sky9464881/tof-lidar-receiver-design/results/bench_final/6.2 final opa695_100  compartor 0 lowpass 5.6pF/opa695 Cin=10pF,Cf=1pF Riso= 0,R695=100 ohm ATT=2 comparator r 0ohm noise.jpg

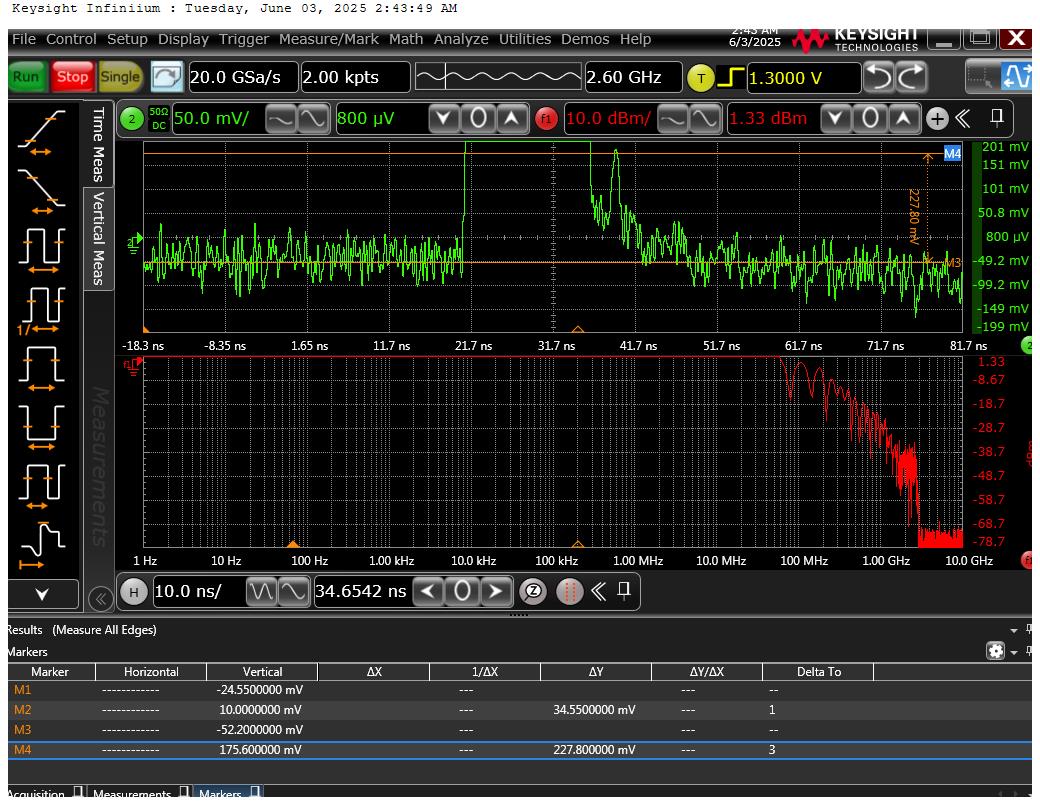
results/bench_final/6.2 final opa695_100 compartor 0 lowpass 5.6pF/opa695 Cin=10pF,Cf=1pF Riso= 0,R695=100 ohm ATT=2 comparator r 0ohm noise.jpg
