sky9464881/tof-lidar-receiver-design/design/footprint_library/footprint/.html

## pad22sq18

date/time: 2023/06/14 16:31:07

type: Through Pin
units: mm
decimal places: 3

Hole data

geometry: Circle
size: 1.800
offset: (0.000, 0.000)
tolerance: positive=0.000 negative=0.000
plating: Plated

Drill symbol data

geometry: Hexagon y
width: 1.270
height: 1.270
characters:

Design layer pads

Layer: TOP

Pad | Geometry | Width | Height | X offset | Y offset
Regular | Square | 2.300 | 2.300 | 0.000 | 0.000
Thermal | None
Anti | None
Keep Out | None

Layer: DEFAULT INTERNAL

Pad | Geometry | Width | Height | X offset | Y offset
Regular | Round | 2.200 | 2.200 | 0.000 | 0.000
Thermal | Round | 1.905 | 1.905 | 0.000 | 0.000
Anti | Round | 1.905 | 1.905 | 0.000 | 0.000
Keep Out | None

Layer: BOTTOM

Pad | Geometry | Width | Height | X offset | Y offset
Regular | Square | 2.300 | 2.300 | 0.000 | 0.000
Thermal | None
Anti | None
Keep Out | None

Layer: ADJACENT LAYER

Pad | Geometry | Width | Height | X offset | Y offset
Regular | None
Thermal | None
Anti | None
Keep Out | None

Mask layer pads

Layer | Geometry | Width | Height | X offset | Y offset
SOLDERMASK_TOP | Square | 1.905 | 1.905 | 0.000 | 0.000
SOLDERMASK_BOTTOM | Square | 1.905 | 1.905 | 0.000 | 0.000
PASTEMASK_TOP | None
PASTEMASK_BOTTOM | None
FILMMASK_TOP | None
FILMMASK_BOTTOM | None
COVERLAY_TOP | None
COVERLAY_BOTTOM | None

Usage options

Suppress unconnected internal pads: No
Allow as template padstack: No
