sky9464881/tof-lidar-receiver-design/docs/drafts/새 Microsoft PowerPoint 프레젠테이션.pptx

## 5/22 미팅용 자료

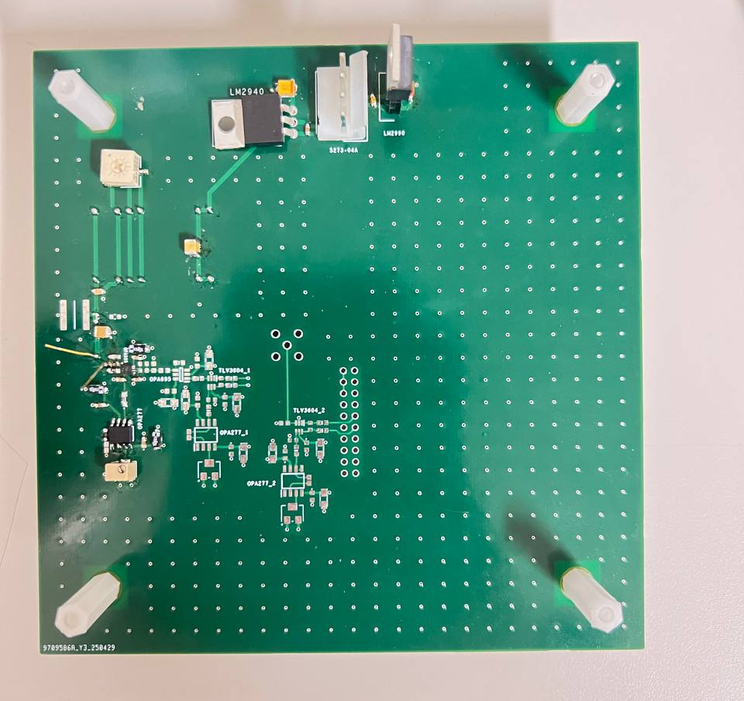
[picture p3: figure]

현재 진행사항

## 5V 전압 인가

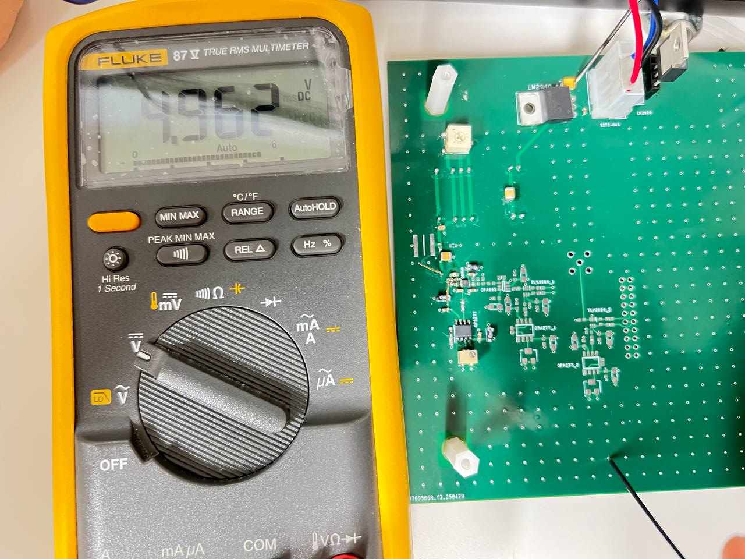
[picture p4: figure]

## -5V 전압 인가

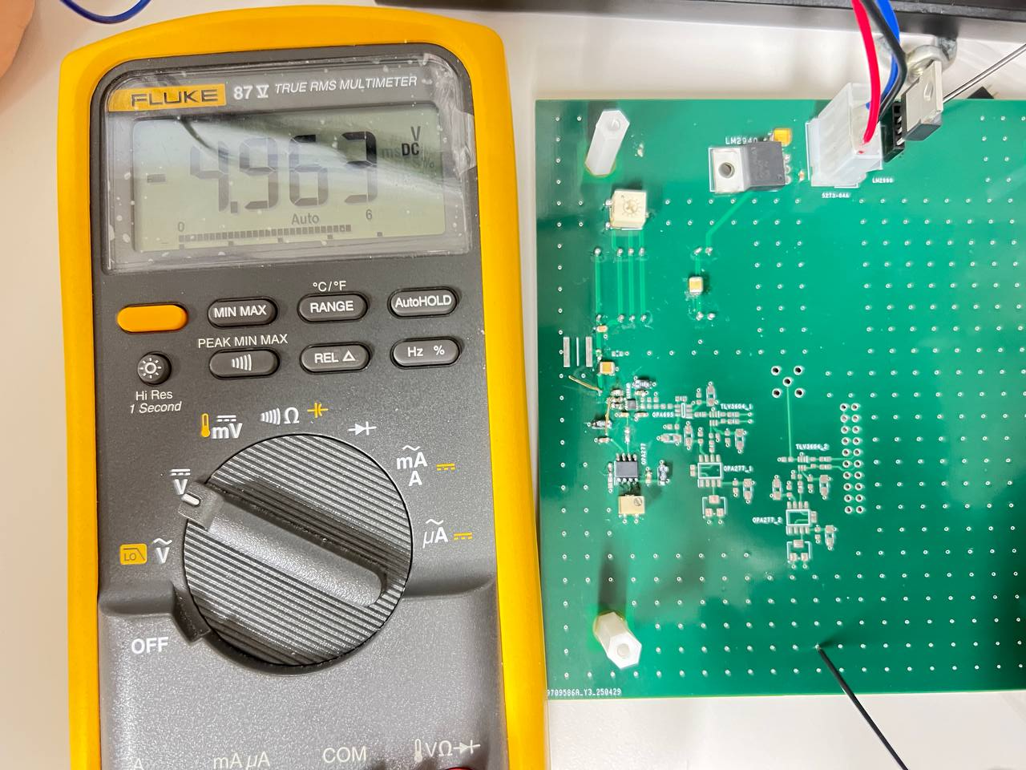
[picture p5: figure]

## apd 바이어스 (120V)

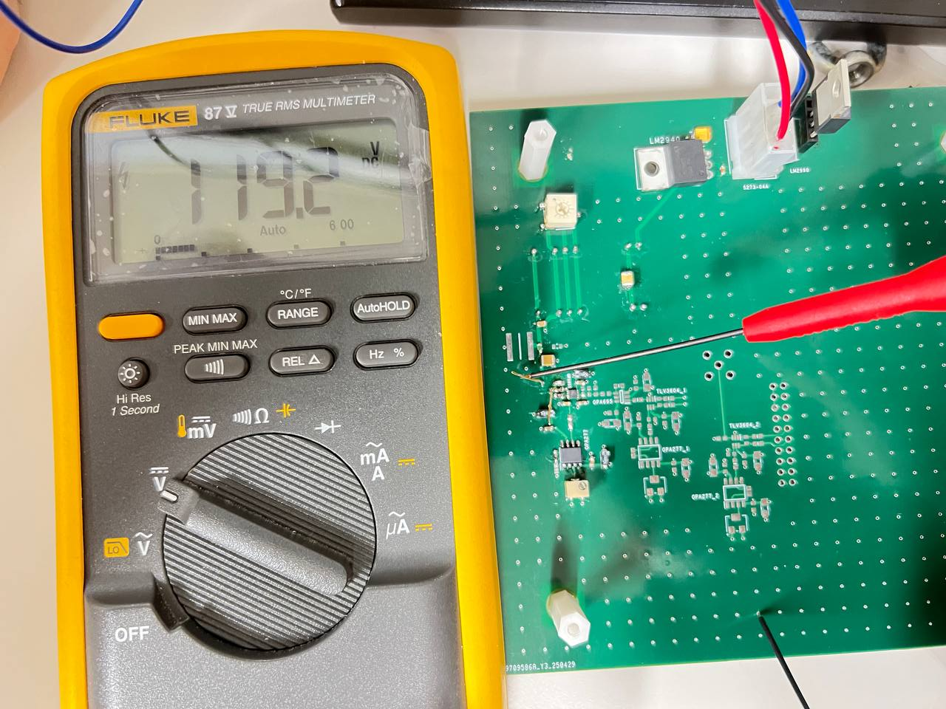
[picture p6: figure]

## OPA855 output offset

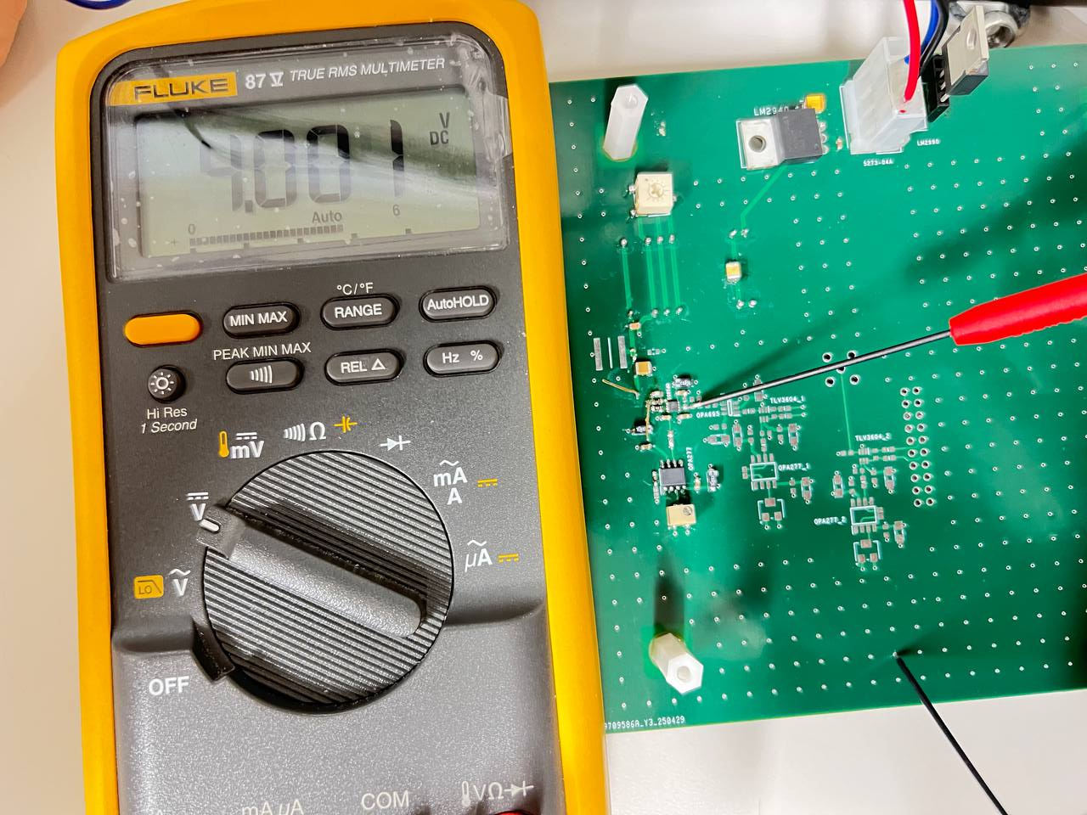
[picture p7: figure]

## OPA 855output 확인용 점프선, RF커넥터

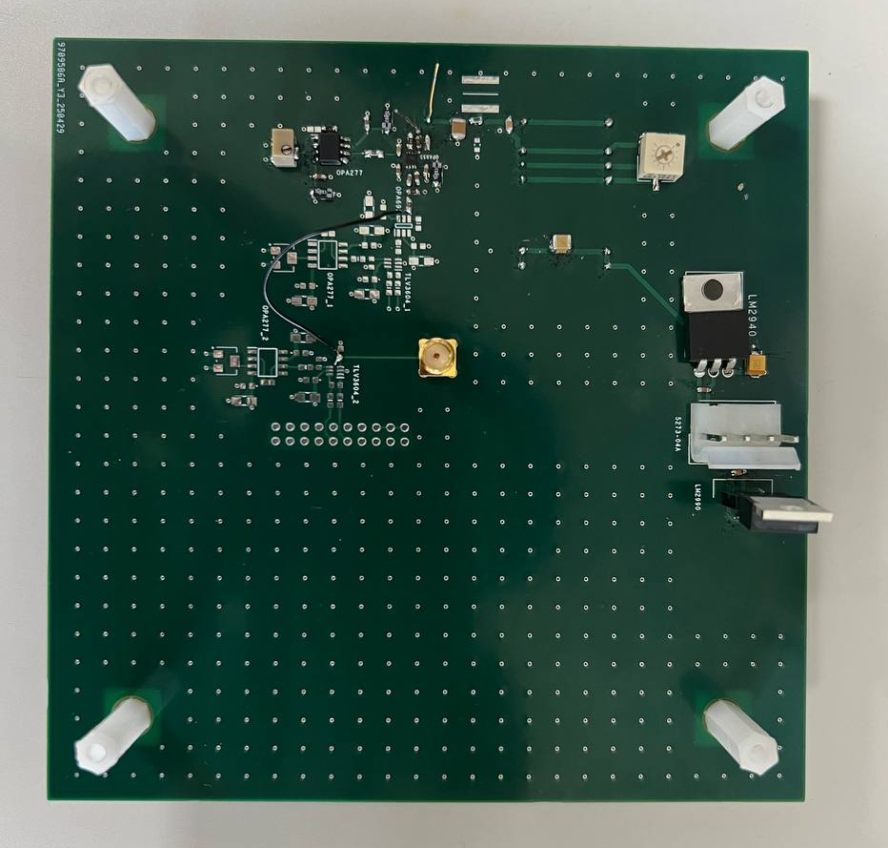
[picture p8: figure]
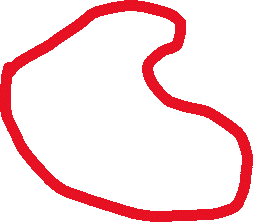
[picture p9: figure]

## Slide 7

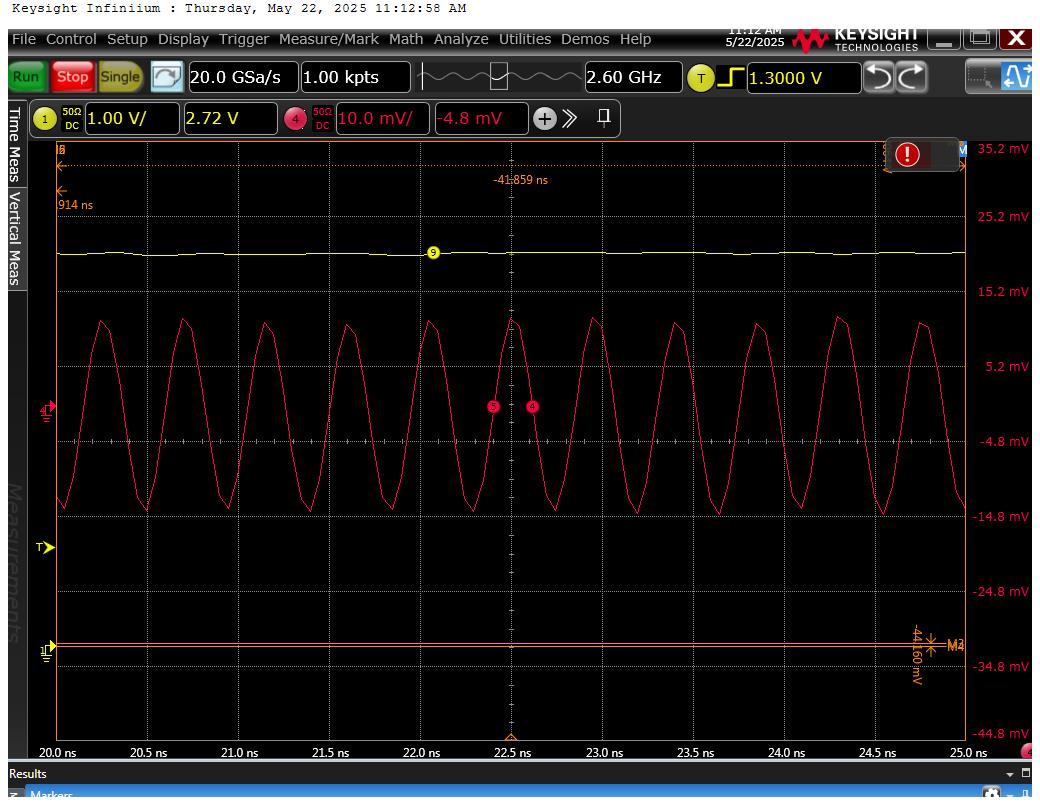
[picture p10: figure]
