sky9464881/tof-lidar-receiver-design/docs/drafts/새 Microsoft Word 문서 (3).docx

1. 시스템 requirement

Dynamic Range | 60dB
거리 범위 | 5.4m~117.9m
해상도(Range resolution) | ≤ 15 [mm] (100 ps walk)

시스템 requirement의 선정 과정를 거치면서 소자 선정과정을 같이 진행해 나갔다. 시스템 requirement를 작성하면서 고려해야할 부분은 Bandwidth, Signal to noise ratio, Dynamic range등 이 있다.

우리는 위에 기준을 먼저 고려하고 그에 맞춰 거리범위까지 선정하였다. 먼저 Bandwidth는 Lidar에 쓰이는 송신부의 rise time과 수신부의 APD의 rise time에 따라 선정된다. 우리가 사용하는 레이저 다이오드는 qs-905-D1S3JT03U로써 그 raise time이 1.4ns이고 APD의 raise time은 0.6ns로 총 rise time은 약 1ns이고 따라서 Bandwidth는 약 350Mhz이다

다음으로는 SNR를 선정하였다. SNR은 전류의 신호의 peak값을 input-referred noise로 나눈 것으로 시스템의 안정성을 위해 8-10 사이의 SNR을 요구하므로 이 캡스톤에서는 10dB의 SNR으로 선정하였다. (참고논문추가) 그리고 TIA출력의 등가 잡음 전압를 계산하고, SNR를 10 dB로 설정하여 APD의 최소 출력 전류 요건을 역 산출하였다. TIA출력의 등가 잡음 전압을 구할 때는 TIA의 피드백 저항과 피드백 캡을 고려해야 한다. 이 부분은 TIA의 saturation 영역을 최대한 포함하지않게 하기 위해 낮은 게인값 즉 저항을 선정하려고 했고 그리고 그 피드백 저항을 고려한 Cap을 선정하려고 했다.

TIA의 등가 잡음 전압은 세가지 noise를 통해 구할 수 있다. Thermal noise, input current noise, voltage noise이다. 이 noise들을 계산해서 총 noise level를 구한다. 이 캡스톤에서는 피드백 소자로 R_f = 500ohm, C_f = 1pF, C_(in) =12pF (기생캐패시턴스를 고려한 캐패시턴스)이다.

f_(3dB) =1/(2πR_f C_f) , ENBW=f_(3dB) ×π/2

TIA의 3dB BW는 위에 식으로 계산하면 318.3MHz이고 ENBW는 500MHz이다

Noise_(Thermal) =√(4kT×ENBW×R_f)

(T:절대 온도 (여기서는 300K로 계산), k: 볼트만상수 1.38× 10^(-28) [J/K])

Noise_(Current) =e_i ×R_f ×√(ENBW)

( e_i : 증폭기의 입력 기준 전류 잡음)

Noise_(Thermal) = e_v ×(C_f +C_(APD) +C_(in))/(C_f)×√(π/2×BW×(C_f)/(C_f +C_(APD) +C_(in)))

( e_v : 증폭기의 입력 기준 전압 잡음)

이러한 최소 광전류는 라이다의 최대 거리 사양과 연결된다.

I_(APD) =P_R ×R_(APD)

( I_(APD) : APD의 전류, P_R : 수신되는 광전력, R_(APD) : APD의 응답도)

P_R =(τ_a ^2 P_T ρ_t A_R)/(πR^2)

( P_T : 레이저 다이오드의 펄스 피크 출력 전력, τ_a : 대기 중 레이저 투과율, ρ_t : 대상 물체의 반사율, A_R : 수신 렌즈의 면적, R : 수신기와 대상 간의 거리)

APD의 응답도인 55A/W와 APD의 전류인 I_(APD) 의 범위를 통해 수신되는 광전력인 P_R 의 범위를 구하고 그에 따라 거리탐지 범위를 산출하였다. 그에 따라 거리인 R 의 범위가 5.4m~117.9m로 정해졌다. 해상도와 관련해서는, 목표 해상도를 시간으로 환산하여 수신부 전자회로의 대역폭인을 고려하여 설정하였다. 이러한 체계적인 접근을 통해 시스템 사양을 현실적으로 달성하기 위한 설계 기준을 확립하였다.

다음으로는 TIA출력의 등가 잡음 전압을 계산한다. TIA의 noise는 크게 세가지로 나눌 수 있다. Thermal noise, input current noise, voltage noise이다. 이 noise를 계산해서 총 noise level를 구한다.

Noise_(Thermal) =√(4kT×ENBW×R_f)
