sky9464881/tof-lidar-receiver-design/docs/drafts/질문.pdf

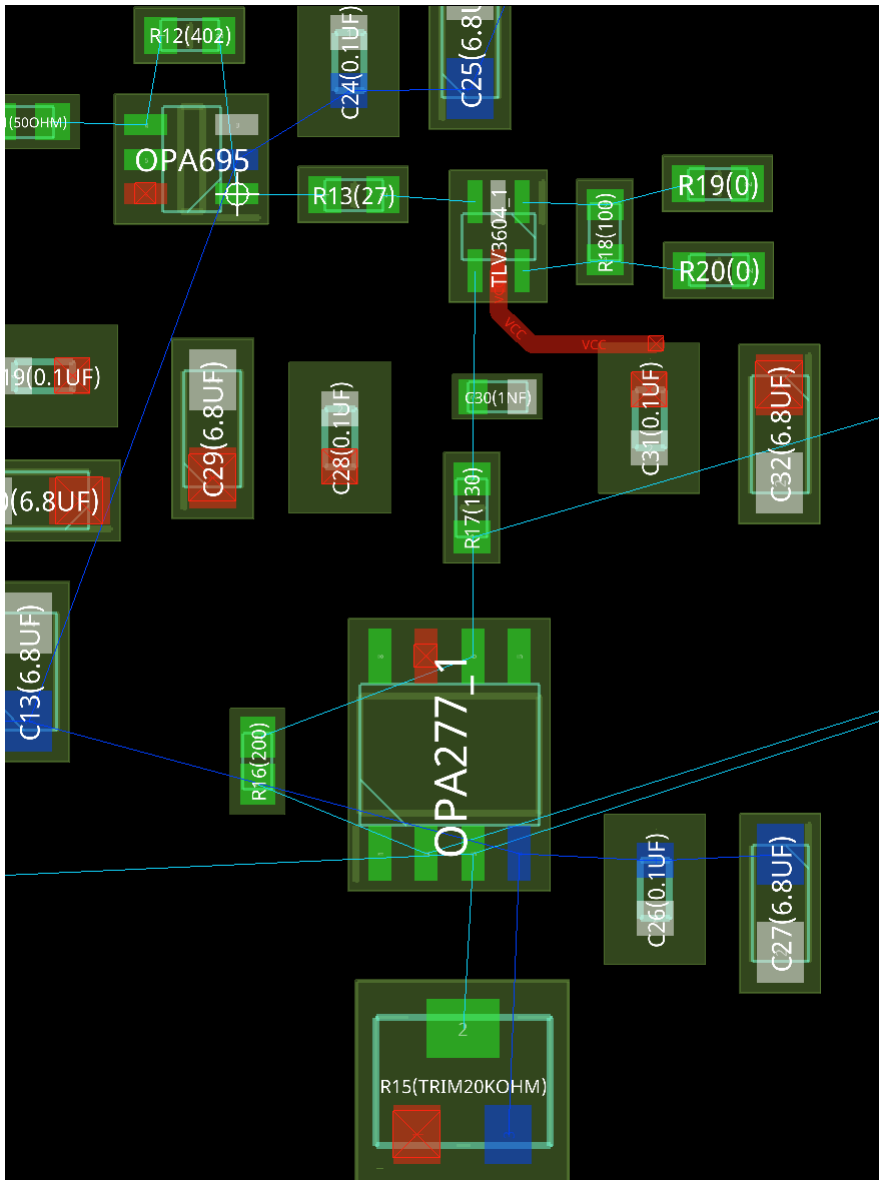
[picture p118: figure]

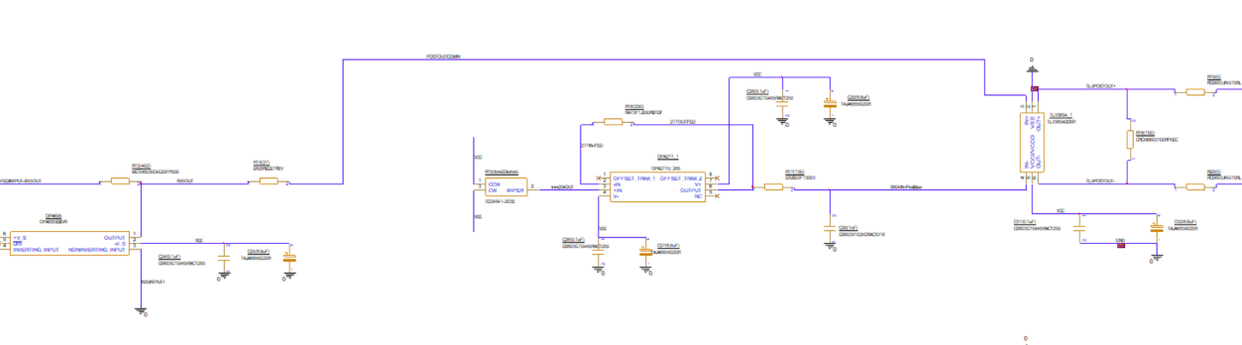
[picture p119: figure]

생각
TLV의 bias는 DR와 직결되니 opa277에 의한 바이어스에 노이즈가 덜 껴야하니 바텀 플 레인으로 내리지 않고 대신 전원부의 바이패스 캐패시터 부분을 직선 연결을 포기하고 45도로 좀 더 넓게 연결. 즉 opa277을 바텀으로 안보냄

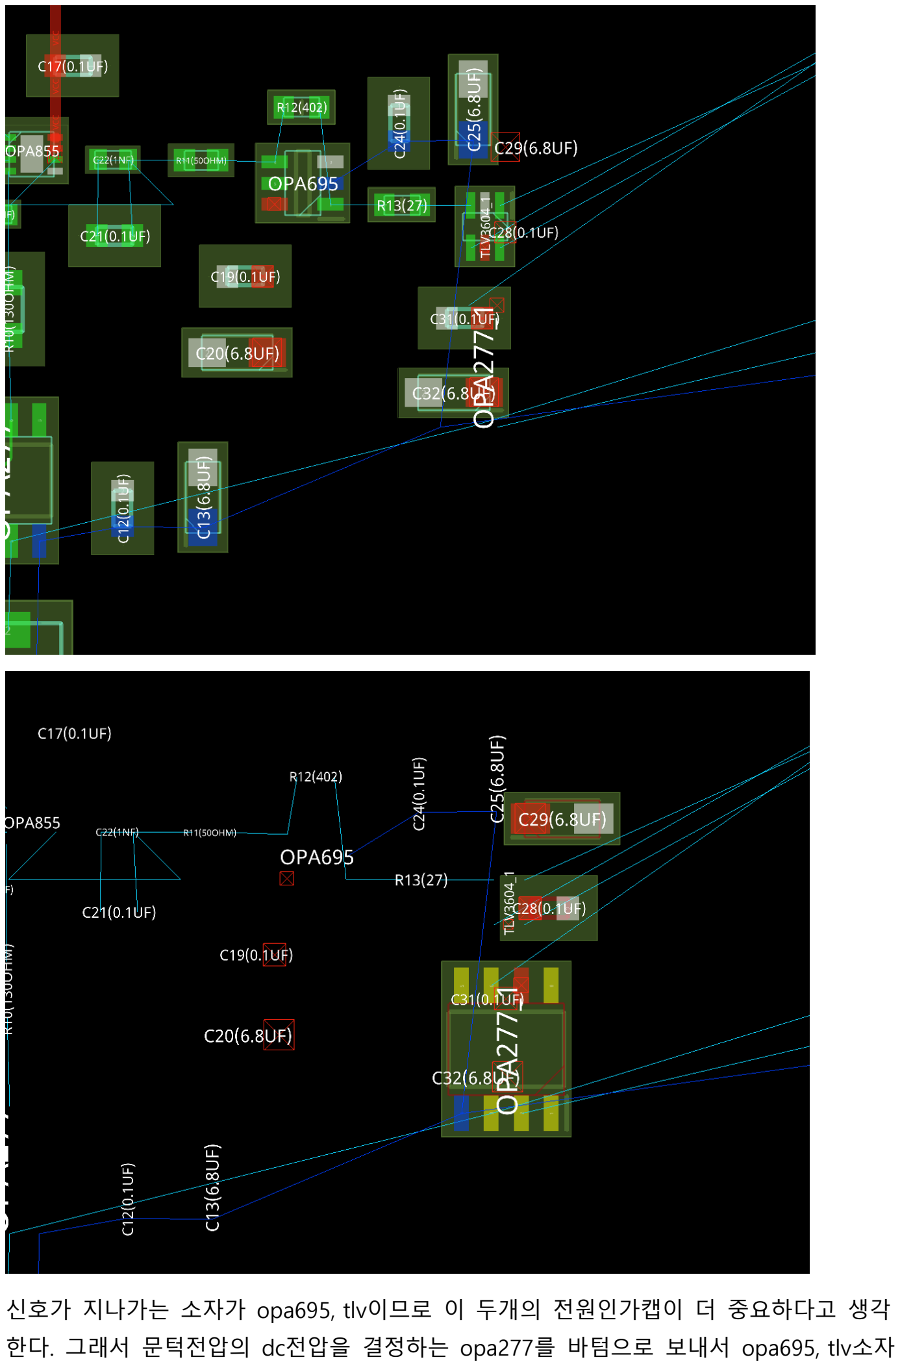
[picture p120: page 3]

신호가 지나가는 소자가 opa695, tlv이므로 이 두개의 전원인가캡이 더 중요하다고 생각 한다. 그래서 문턱전압의 dc전압을 결정하는 opa277를 바텀으로 보내서 opa695, tlv소자

의 전원인가 캡을 더 가까이 붙일 수 있게 공간을 확보한다.
