sky9464881/tof-lidar-receiver-design/design/schematic/main_receiver_board.png

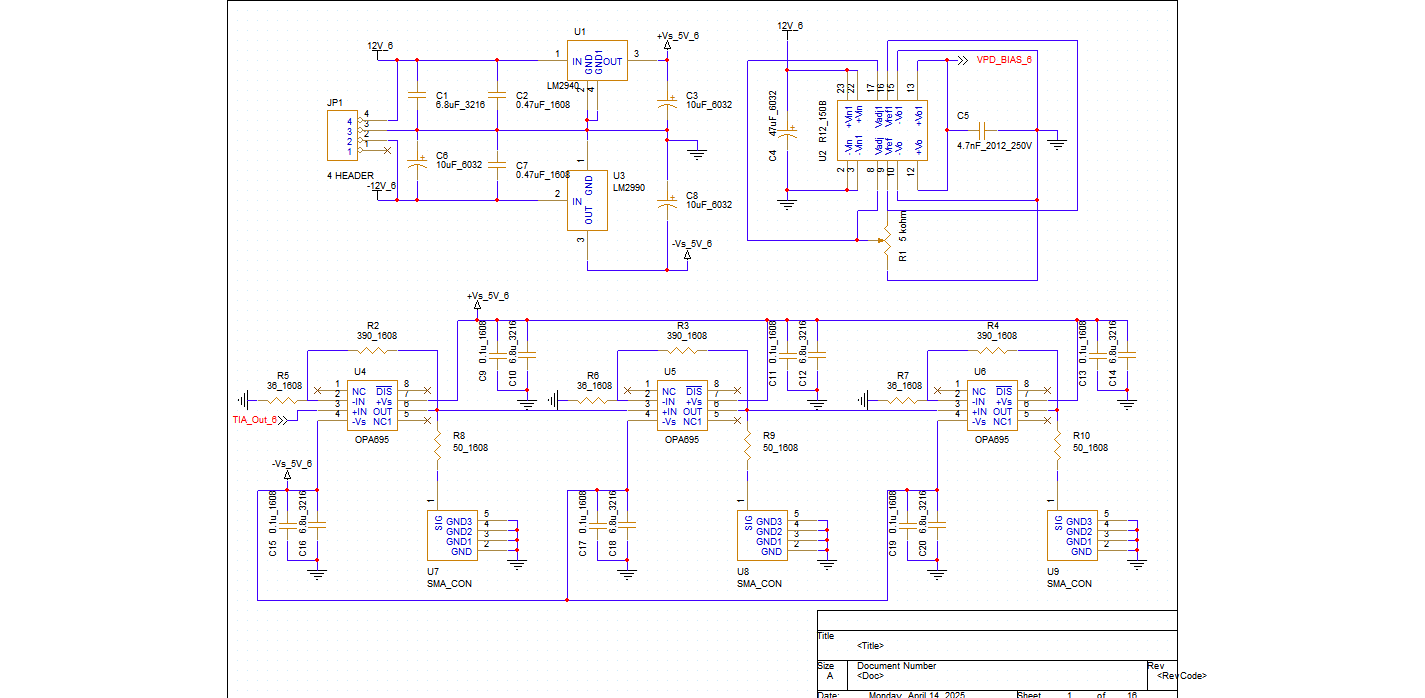
design/schematic/main_receiver_board.png
