sky9464881/tof-lidar-receiver-design/design/schematic/receiver_readout_v1.png

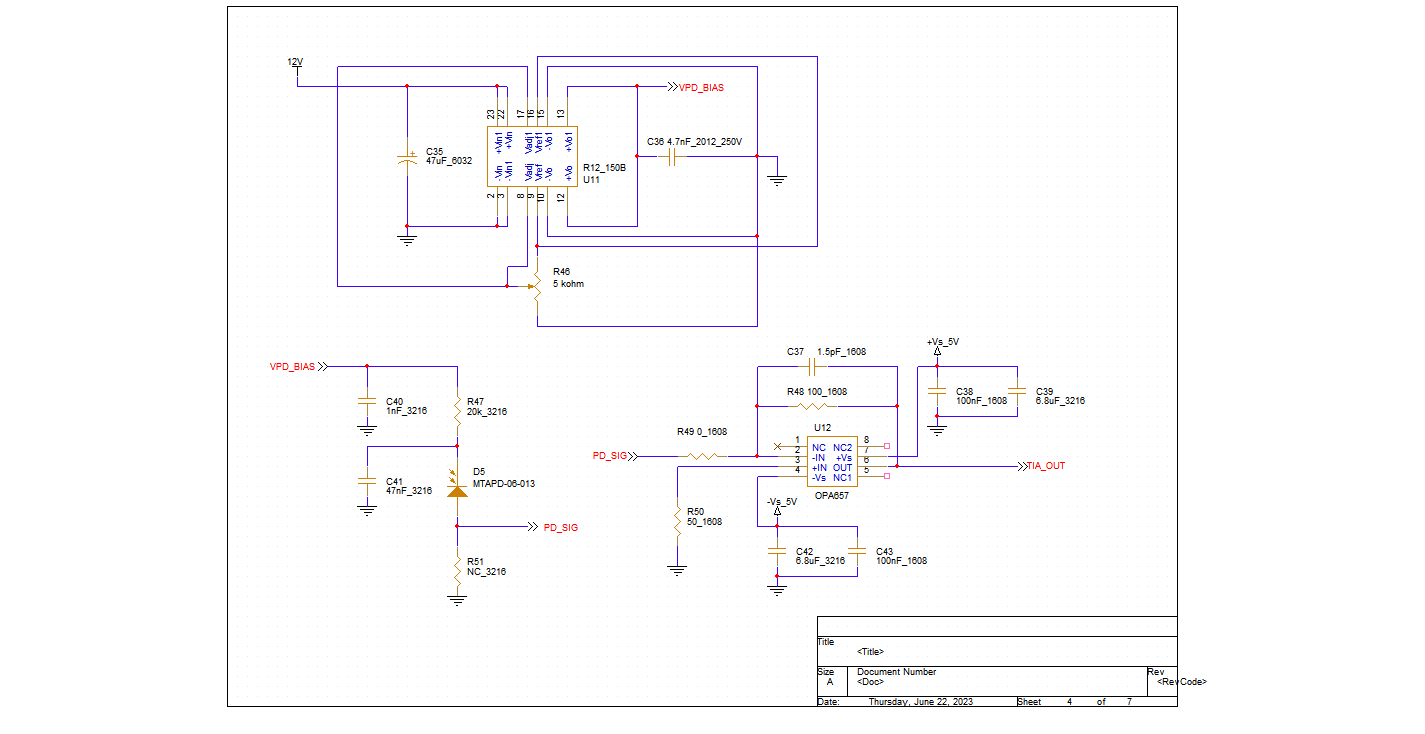
design/schematic/receiver_readout_v1.png
