sky9464881/tof-lidar-receiver-design/design/schematic/전원.jpg

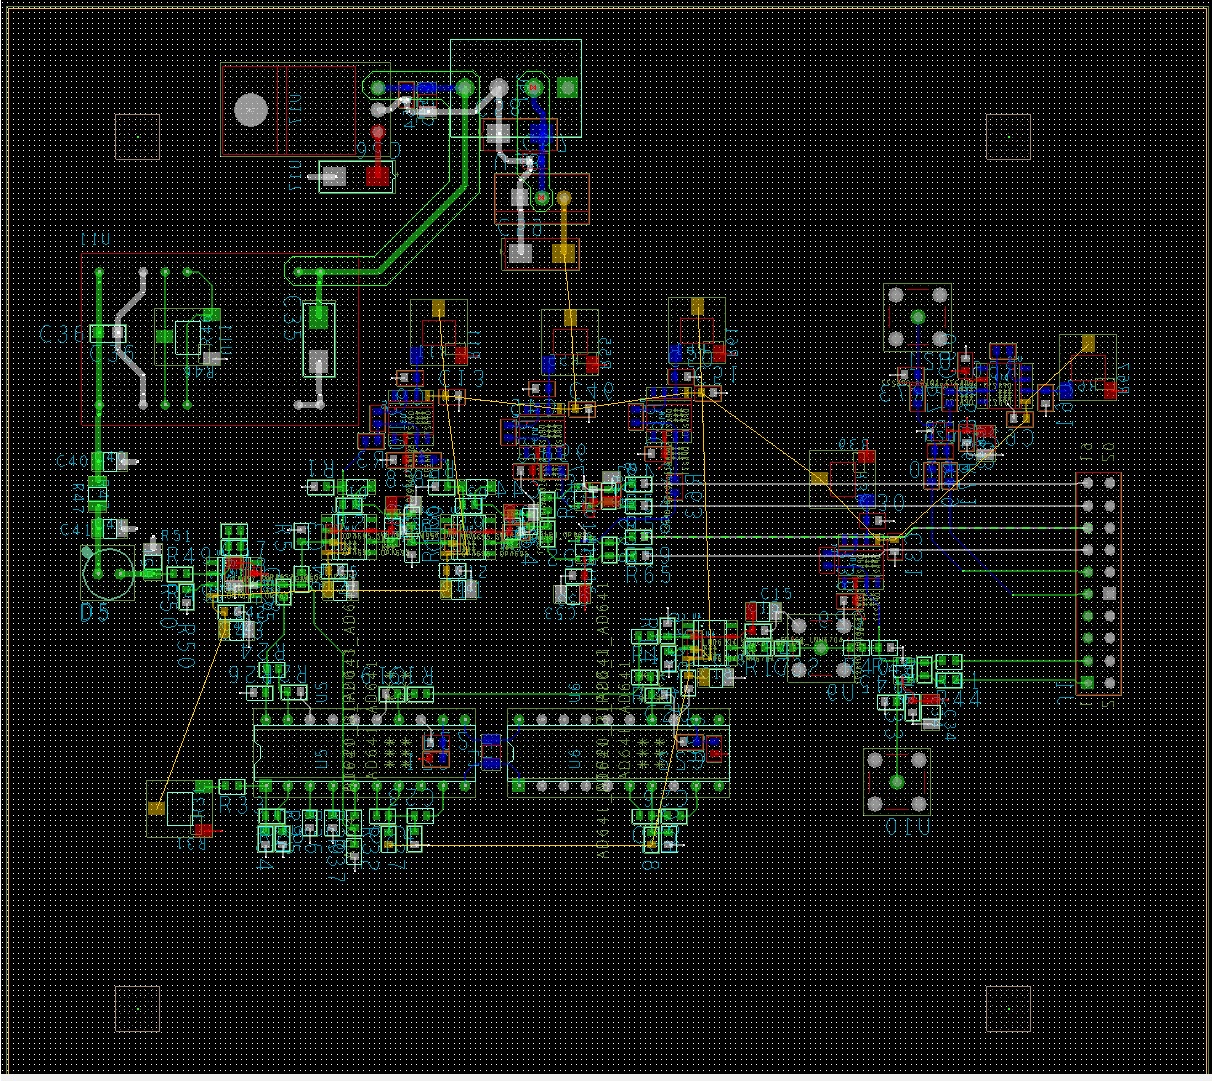
design/schematic/전원.jpg
