sky9464881/tof-lidar-receiver-design/simulation/project_backups/revised_receiver_project_backup/new_lidar/NEW_LIDAR.png

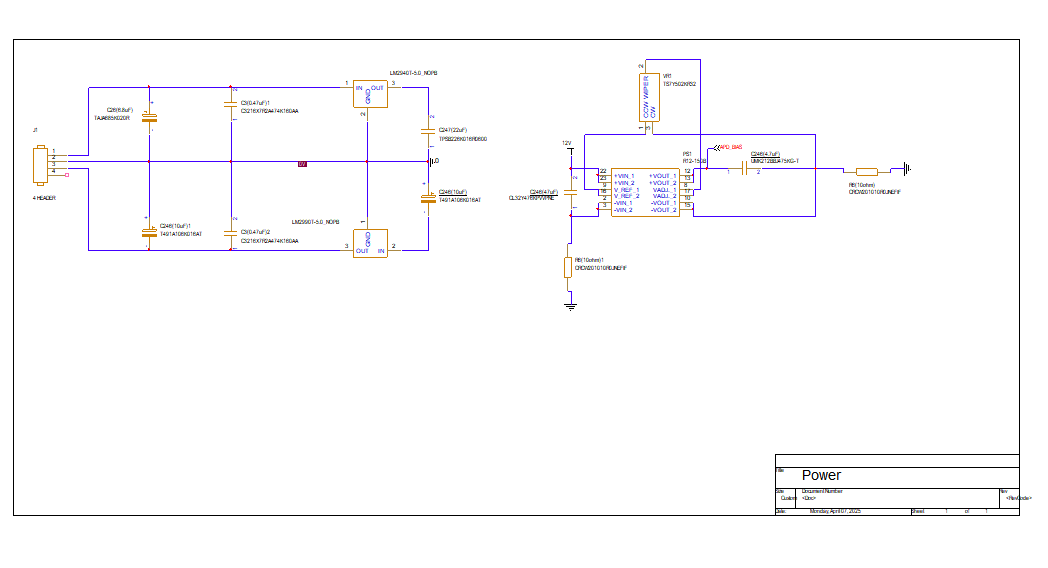
simulation/project_backups/revised_receiver_project_backup/new_lidar/NEW_LIDAR.png
