sky9464881/tof-lidar-receiver-design/simulation/pspice_main/main_pcb_project/LIDAR_PCB.png

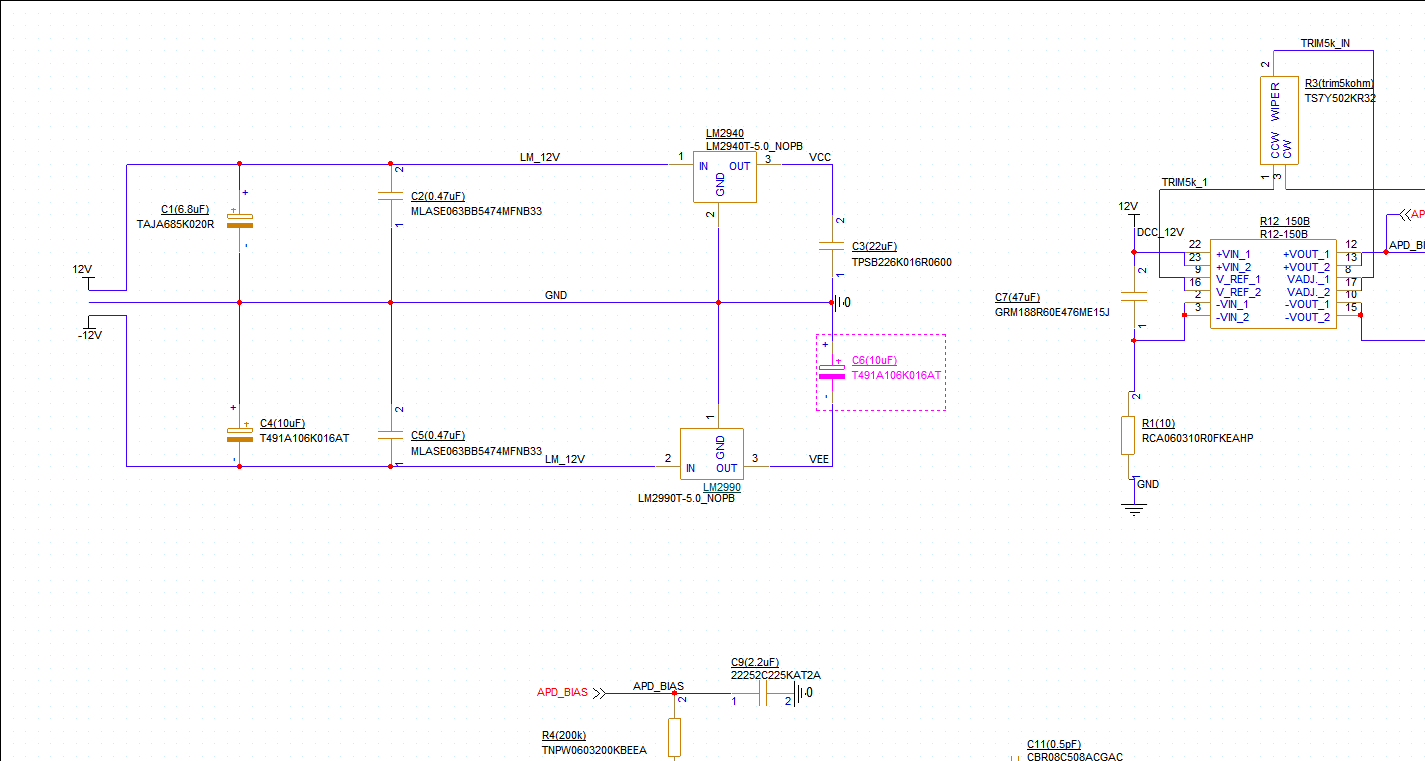
simulation/pspice_main/main_pcb_project/LIDAR_PCB.png
