sky9464881/tof-lidar-receiver-design/simulation/pspice_main/main_receiver_project/LIDARPROJECT.png

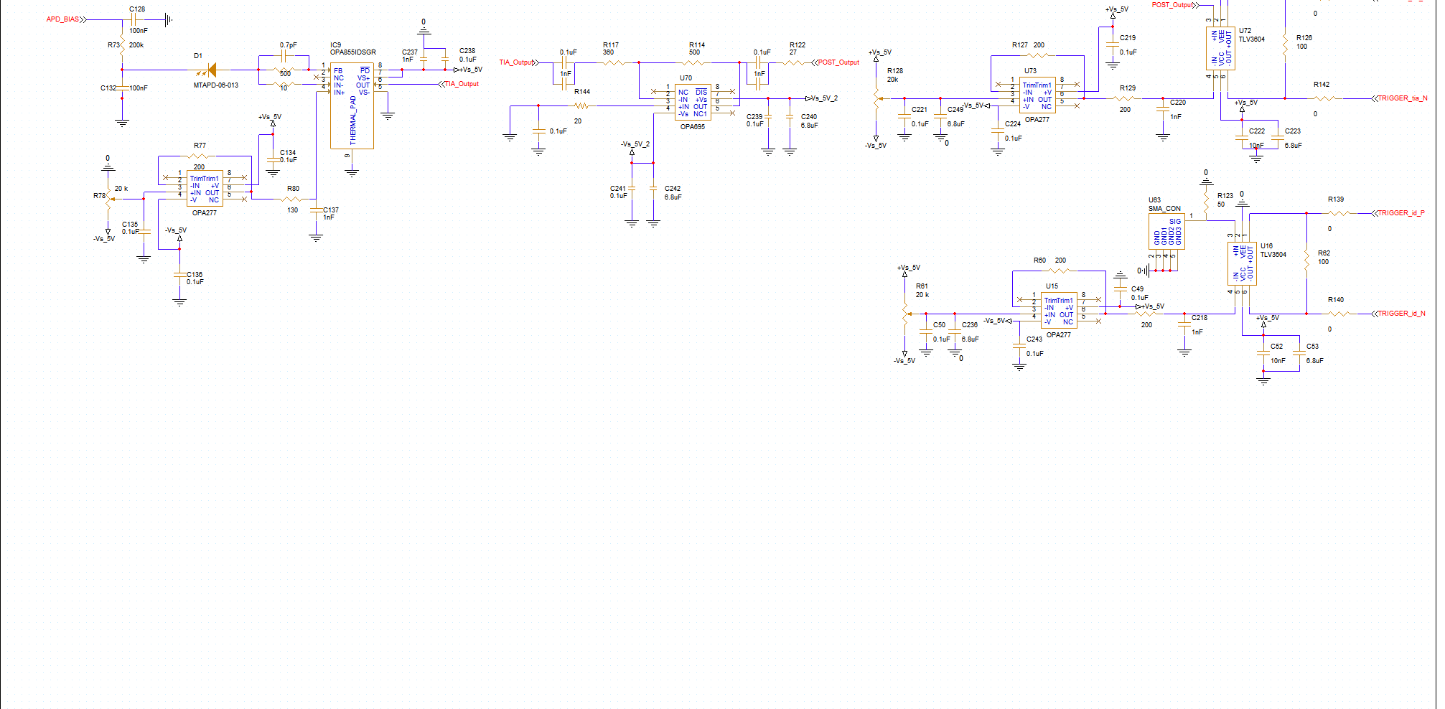
simulation/pspice_main/main_receiver_project/LIDARPROJECT.png
