sky9464881/tof-lidar-receiver-design/simulation/tool_meta/designs/DESIGN1.png

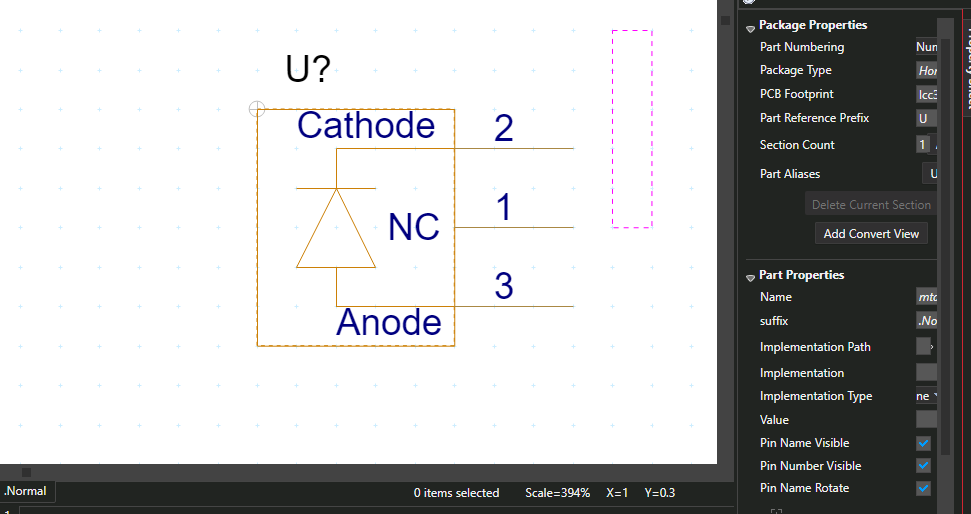
simulation/tool_meta/designs/DESIGN1.png
