sky9464881/tof-lidar-receiver-design/simulation/tool_meta/designs/DESIGN2.png

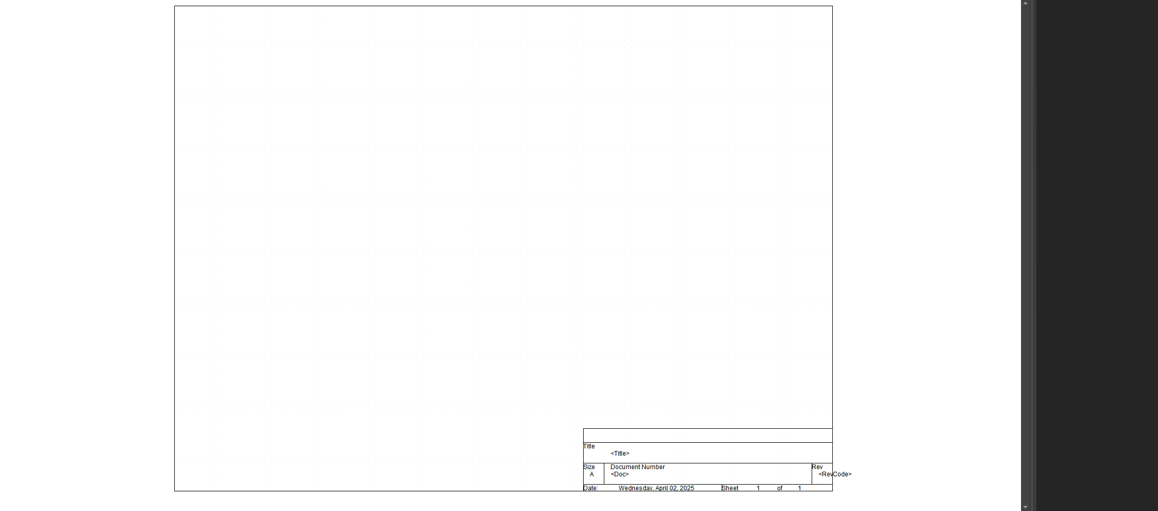
simulation/tool_meta/designs/DESIGN2.png
