sky9464881/tof-lidar-receiver-design/simulation/pspice_main/main_pcb_project/lidar_pcb_output/bom.sch.csv

Item Number | Quantity | Value | Description | Part Number | Part Reference | Manufacturer Name | Manufacturer Part Number | ID | SKU | ALT_MPN | ALT_MFR
1 | 1 | MTAPD-06-013 | SENSOR PHOTODIODE 905NM TO46-2 | MTAPD-06-013 | APD | Marktech Optoelectronics | MTAPD-06-013 | 106
2 | 1 | TAJA685K020R | AVX 6.8uF SMD Solid MnO2 Tantalum Electrolytic Capacitor, 20 V dc +/-10%, TAJ Series | TAJA685K020R | C1(6.8UF) | Kyocera AVX | TAJA685K020R | 300
3 | 1 | MLASE063BB5474MFNB33 | 0.47 F +/-20% 16V Ceramic Capacitor X5R 0201 (0603 Metric) | (C_0.47uF0603)MLASE063BB5474MFNB33 | C2(0.47UF) | TAIYO YUDEN | MLASE063BB5474MFNB33 | 483
4 | 1 | TPSB226K016R0600 | AVX 22 | TPSB226K016R0600 | C3(22UF) | Kyocera AVX | TPSB226K016R0600 | 109
5 | 1 | T491A106K016AT | T491, Tantalum, MnO2 Tantalum, Commercial Grade, 10 uF, 10%, 16 VDC, 125C, -55C, 85C, SMD, MnO2, Molded, 6 % , 3 Ohms, 1600 nA, 58.6 mg, 3216, 1.6mm, Height Max = 1.8mm, 2000, 156 Weeks | T491A106K016AT | C4(10UF) | KEMET | T491A106K016AT | 223
6 | 1 | MLASE063BB5474MFNB33 | 0.47 F +/-20% 16V Ceramic Capacitor X5R 0201 (0603 Metric) | (C_0.47uF0603)MLASE063BB5474MFNB33 | C5(0.47UF) | TAIYO YUDEN | MLASE063BB5474MFNB33 | 486
7 | 1 | T491A106K016AT | T491, Tantalum, MnO2 Tantalum, Commercial Grade, 10 uF, 10%, 16 VDC, 125C, -55C, 85C, SMD, MnO2, Molded, 6 % , 3 Ohms, 1600 nA, 58.6 mg, 3216, 1.6mm, Height Max = 1.8mm, 2000, 156 Weeks | T491A106K016AT | C6(10UF) | KEMET | T491A106K016AT | 169
8 | 1 | GRM188R60E476ME15J | MLCC, 0603 | (C_47uF0603)GRM188R60E476ME15J | C7(47UF) | Murata Electronics | GRM188R60E476ME15J | 489
9 | 1 | 02016D475MAT2A | Multilayer Ceramic Capacitors MLCC - SMD/SMT 6.3V 4.7uF X5R 0201 20% |  | C8(4.7UF) |  |  | 492
10 | 1 | 22252C225KAT2A | Multilayer Ceramic Capacitors MLCC - SMD/SMT 200V 2.2uF 2225 10% X7R | (C_2.2uF_APD)22252C225KAT2A | C9(2.2UF) |  |  | 671
11 | 1 | VJ1210Y104MXCAT | Multilayer Ceramic Capacitors MLCC - SMD/SMT 0.1uF 200V X7R 20% | (C_0.1uF_APD)VJ1210Y104MXCAT | C10(0.1UF) | Vishay | VJ1210Y104MXCAT | 674
12 | 1 | CBR08C508ACGAC | CBR-SMD RF C0G, Ceramic, 0.5 pF, +/-0.05 pF, 500 VDC, 750 VDC, 125C, -55C, C0G, SMD, Fixed, RF, Ultra High Q, Low ESR, Class I, 0.24 % , 10 GOhms, 410, 10.7 mg, 0805, 2mm, 1.25mm, 0.85mm, 0.5mm, 4000, 78 Weeks, 120 | (0.5pF)CBR08C508ACGAC | C11(0.5PF) |  |  | 382
13 | 1 | C0603G104K5RACT250 | SMD Indust X7R HT175C, Ceramic, 0.1 uF, 10%, 50 VDC, 125 VDC, 175C, -55C, X7R, SMD, MLCC, High Temperature, Class II, 2.5 % , 5 GOhms, 4.8 mg, 0603, 1.6mm, 0.8mm, 0.8mm, 0.7mm, 0.35mm, 250, 78 Weeks, 80 | C0603G104K5RACT250 | C12(0.1UF) | KEMET | C0603G104K5RACT250 | 143
14 | 1 | TAJA685K020R | AVX 6.8uF SMD Solid MnO2 Tantalum Electrolytic Capacitor, 20 V dc +/-10%, TAJ Series | TAJA685K020R | C13(6.8UF) | Kyocera AVX | TAJA685K020R | 450
15 | 1 | C0603G104K5RACT250 | SMD Indust X7R HT175C, Ceramic, 0.1 uF, 10%, 50 VDC, 125 VDC, 175C, -55C, X7R, SMD, MLCC, High Temperature, Class II, 2.5 % , 5 GOhms, 4.8 mg, 0603, 1.6mm, 0.8mm, 0.8mm, 0.7mm, 0.35mm, 250, 78 Weeks, 80 | C0603G104K5RACT250 | C14(0.1UF) | KEMET | C0603G104K5RACT250 | 232
16 | 1 | TAJA685K020R | AVX 6.8uF SMD Solid MnO2 Tantalum Electrolytic Capacitor, 20 V dc +/-10%, TAJ Series | TAJA685K020R | C15(6.8UF) | Kyocera AVX | TAJA685K020R | 453
17 | 1 | C0603X102KCRAC3316 | Charging stations LCD fluorescent backlight ballasts Voltage multiplier circuits DC/DC converters Power supply LAN/WAN interface High voltage decoupling Filters DC blocking ESD Protection | (C_1nF0603)C0603X102KCRAC3316 | C16(1NF) |  |  | 519
18 | 1 | C0603G104K5RACT250 | SMD Indust X7R HT175C, Ceramic, 0.1 uF, 10%, 50 VDC, 125 VDC, 175C, -55C, X7R, SMD, MLCC, High Temperature, Class II, 2.5 % , 5 GOhms, 4.8 mg, 0603, 1.6mm, 0.8mm, 0.8mm, 0.7mm, 0.35mm, 250, 78 Weeks, 80 | C0603G104K5RACT250 | C17(0.1UF) | KEMET | C0603G104K5RACT250 | 45
19 | 1 | TAJA685K020R | AVX 6.8uF SMD Solid MnO2 Tantalum Electrolytic Capacitor, 20 V dc +/-10%, TAJ Series | TAJA685K020R | C18(6.8UF) | Kyocera AVX | TAJA685K020R | 456
20 | 1 | C0603G104K5RACT250 | SMD Indust X7R HT175C, Ceramic, 0.1 uF, 10%, 50 VDC, 125 VDC, 175C, -55C, X7R, SMD, MLCC, High Temperature, Class II, 2.5 % , 5 GOhms, 4.8 mg, 0603, 1.6mm, 0.8mm, 0.8mm, 0.7mm, 0.35mm, 250, 78 Weeks, 80 | (0.1uF)C0603G104K5RACT250 | C19(0.1UF) | KEMET | C0603G104K5RACT250 | 441
21 | 1 | TAJA685K020R | AVX 6.8uF SMD Solid MnO2 Tantalum Electrolytic Capacitor, 20 V dc +/-10%, TAJ Series | TAJA685K020R | C20(6.8UF) | Kyocera AVX | TAJA685K020R | 72
22 | 1 | C0603G104K5RACT250 | SMD Indust X7R HT175C, Ceramic, 0.1 uF, 10%, 50 VDC, 125 VDC, 175C, -55C, X7R, SMD, MLCC, High Temperature, Class II, 2.5 % , 5 GOhms, 4.8 mg, 0603, 1.6mm, 0.8mm, 0.8mm, 0.7mm, 0.35mm, 250, 78 Weeks, 80 | C0603G104K5RACT250 | C21(0.1UF) | KEMET | C0603G104K5RACT250 | 245
23 | 1 | C0603X102KCRAC3316 | Charging stations LCD fluorescent backlight ballasts Voltage multiplier circuits DC/DC converters Power supply LAN/WAN interface High voltage decoupling Filters DC blocking ESD Protection | (C_1nF0603)C0603X102KCRAC3316 | C22(1NF) |  |  | 522
24 | 1 | C0603G104K5RACT250 | SMD Indust X7R HT175C, Ceramic, 0.1 uF, 10%, 50 VDC, 125 VDC, 175C, -55C, X7R, SMD, MLCC, High Temperature, Class II, 2.5 % , 5 GOhms, 4.8 mg, 0603, 1.6mm, 0.8mm, 0.8mm, 0.7mm, 0.35mm, 250, 78 Weeks, 80 | (0.1uF)C0603G104K5RACT250 | C24(0.1UF) | KEMET | C0603G104K5RACT250 | 459
25 | 1 | TAJA685K020R | AVX 6.8uF SMD Solid MnO2 Tantalum Electrolytic Capacitor, 20 V dc +/-10%, TAJ Series | TAJA685K020R | C25(6.8UF) | Kyocera AVX | TAJA685K020R | 140
26 | 1 | C0603G104K5RACT250 | SMD Indust X7R HT175C, Ceramic, 0.1 uF, 10%, 50 VDC, 125 VDC, 175C, -55C, X7R, SMD, MLCC, High Temperature, Class II, 2.5 % , 5 GOhms, 4.8 mg, 0603, 1.6mm, 0.8mm, 0.8mm, 0.7mm, 0.35mm, 250, 78 Weeks, 80 | C0603G104K5RACT250 | C26(0.1UF) | KEMET | C0603G104K5RACT250 | 178
27 | 1 | TAJA685K020R | AVX 6.8uF SMD Solid MnO2 Tantalum Electrolytic Capacitor, 20 V dc +/-10%, TAJ Series | TAJA685K020R | C27(6.8UF) | Kyocera AVX | TAJA685K020R | 465
28 | 1 | C0603G104K5RACT250 | SMD Indust X7R HT175C, Ceramic, 0.1 uF, 10%, 50 VDC, 125 VDC, 175C, -55C, X7R, SMD, MLCC, High Temperature, Class II, 2.5 % , 5 GOhms, 4.8 mg, 0603, 1.6mm, 0.8mm, 0.8mm, 0.7mm, 0.35mm, 250, 78 Weeks, 80 | C0603G104K5RACT250 | C28(0.1UF) | KEMET | C0603G104K5RACT250 | 131
29 | 1 | TAJA685K020R | AVX 6.8uF SMD Solid MnO2 Tantalum Electrolytic Capacitor, 20 V dc +/-10%, TAJ Series | TAJA685K020R | C29(6.8UF) | Kyocera AVX | TAJA685K020R | 468
30 | 1 | C0603X102KCRAC3316 | Charging stations LCD fluorescent backlight ballasts Voltage multiplier circuits DC/DC converters Power supply LAN/WAN interface High voltage decoupling Filters DC blocking ESD Protection | (C_1nF0603)C0603X102KCRAC3316 | C30(1NF) |  |  | 550
31 | 1 | C0603G104K5RACT250 | SMD Indust X7R HT175C, Ceramic, 0.1 uF, 10%, 50 VDC, 125 VDC, 175C, -55C, X7R, SMD, MLCC, High Temperature, Class II, 2.5 % , 5 GOhms, 4.8 mg, 0603, 1.6mm, 0.8mm, 0.8mm, 0.7mm, 0.35mm, 250, 78 Weeks, 80 | C0603G104K5RACT250 | C31(0.1UF) | KEMET | C0603G104K5RACT250 | 471
32 | 1 | TAJA685K020R | AVX 6.8uF SMD Solid MnO2 Tantalum Electrolytic Capacitor, 20 V dc +/-10%, TAJ Series | TAJA685K020R | C32(6.8UF) | Kyocera AVX | TAJA685K020R | 100
33 | 1 | C0603G104K5RACT250 | SMD Indust X7R HT175C, Ceramic, 0.1 uF, 10%, 50 VDC, 125 VDC, 175C, -55C, X7R, SMD, MLCC, High Temperature, Class II, 2.5 % , 5 GOhms, 4.8 mg, 0603, 1.6mm, 0.8mm, 0.8mm, 0.7mm, 0.35mm, 250, 78 Weeks, 80 | C0603G104K5RACT250 | C33(0.1UF) | KEMET | C0603G104K5RACT250 | 85
34 | 1 | TAJA685K020R | AVX 6.8uF SMD Solid MnO2 Tantalum Electrolytic Capacitor, 20 V dc +/-10%, TAJ Series | TAJA685K020R | C34(6.8UF) | Kyocera AVX | TAJA685K020R | 480
35 | 1 | C0603G104K5RACT250 | SMD Indust X7R HT175C, Ceramic, 0.1 uF, 10%, 50 VDC, 125 VDC, 175C, -55C, X7R, SMD, MLCC, High Temperature, Class II, 2.5 % , 5 GOhms, 4.8 mg, 0603, 1.6mm, 0.8mm, 0.8mm, 0.7mm, 0.35mm, 250, 78 Weeks, 80 | C0603G104K5RACT250 | C35(0.1UF) | KEMET | C0603G104K5RACT250 | 134
36 | 1 | TAJA685K020R | AVX 6.8uF SMD Solid MnO2 Tantalum Electrolytic Capacitor, 20 V dc +/-10%, TAJ Series | TAJA685K020R | C36(6.8UF) | Kyocera AVX | TAJA685K020R | 477
37 | 1 | C0603X102KCRAC3316 | Charging stations LCD fluorescent backlight ballasts Voltage multiplier circuits DC/DC converters Power supply LAN/WAN interface High voltage decoupling Filters DC blocking ESD Protection | (C_1nF0603)C0603X102KCRAC3316 | C37(1NF) |  |  | 553
38 | 1 | C0603G104K5RACT250 | SMD Indust X7R HT175C, Ceramic, 0.1 uF, 10%, 50 VDC, 125 VDC, 175C, -55C, X7R, SMD, MLCC, High Temperature, Class II, 2.5 % , 5 GOhms, 4.8 mg, 0603, 1.6mm, 0.8mm, 0.8mm, 0.7mm, 0.35mm, 250, 78 Weeks, 80 | C0603G104K5RACT250 | C38(0.1UF) | KEMET | C0603G104K5RACT250 | 474
39 | 1 | TAJA685K020R | AVX 6.8uF SMD Solid MnO2 Tantalum Electrolytic Capacitor, 20 V dc +/-10%, TAJ Series | TAJA685K020R | C39(6.8UF) | Kyocera AVX | TAJA685K020R | 103
40 | 1 | LM2940T-5.0_NOPB | Texas Instruments LM2940T-5.0/NOPB, LDO Voltage Regulator, 1A, 5 V, 6.25 26 Vin 3-Pin, TO-220 | LM2940T-5.0/NOPB | LM2940 | Texas Instruments | LM2940T-5.0/NOPB | 241
41 | 1 | LM2990T-5.0_NOPB | Texas Instruments LM2990T-5.0/NOPB, LDO Voltage Regulator, 1A, -5 V +/-5%, -26 0.3 Vin, 3-Pin TO-220 | LM2990T-5.0/NOPB | LM2990 | Texas Instruments | LM2990T-5.0/NOPB | 23
42 | 1 | OPA277U_2K5 | High Precision Operational Amplifiers | OPA277U/2K5 | OPA277_1 | Texas Instruments | OPA277U/2K5 | 387
43 | 1 | OPA277U_2K5 | High Precision Operational Amplifiers | OPA277U/2K5 | OPA277 | Texas Instruments | OPA277U/2K5 | 30
44 | 1 | OPA277U_2K5 | High Precision Operational Amplifiers | OPA277U/2K5 | OPA277_2 | Texas Instruments | OPA277U/2K5 | 412
45 | 1 | OPA695IDBVR | Ultra-Wideband, Current-Feedback Operational Amplifier with Disable | OPA695IDBVR | OPA695 | Texas Instruments | OPA695IDBVR | 254
46 | 1 | OPA855IDSGT | High Speed Operational Amplifiers 8 GHz Gain Bandwidth Product, Decompensated Transimpedance Amplifier with Bipolar Input 8-WSON -40 to 125 | OPA855IDSGT | OPA855 | Texas Instruments | OPA855IDSGT | 660
47 | 1 | RCA060310R0FKEAHP | Thick Film Resistors - SMD 10 OHM 1% 1/3W | (R_10_ohm0603)RCA060310R0FKEAHP | R1(10) | Vishay | RCA060310R0FKEAHP | 495
48 | 1 | RCA060310R0FKEAHP | Thick Film Resistors - SMD 10 OHM 1% 1/3W | (R_10_ohm0603)RCA060310R0FKEAHP | R2(10) | Vishay | RCA060310R0FKEAHP | 498
49 | 1 | TS7Y502KR32 | 5 kOhms 0.5W, 1/2W Gull Wing Surface Mount Trimmer Potentiometer Cermet 1.0 Turn Top Adjustment | TS7Y502KR32 | R3(TRIM5KOHM) | Vishay | TS7Y502KR32 | 181
50 | 1 | TNPW0603200KBEEA | Vishay TNPW Series Thin Film Surface Mount Resistor 0603 Case 200k +/-0.1% 0.1W +/-25ppm/K | (R_200k_ohm0603)TNPW0603200KBEEA | R4(200K) | Vishay | TNPW0603200KBEEA | 501
51 | 1 | PLT0603Z5000AST5 | Thin Film Resistors - SMD 150mW 500OHM 0.05% 0603 5PPM | (R_500_ohm0603)PLT0603Z5000AST5 | R5(500) | Vishay | PLT0603Z5000AST5 | 504
52 | 1 | RCA060310R0FKEAHP | Thick Film Resistors - SMD 10 OHM 1% 1/3W | (R_10_ohm0603)RCA060310R0FKEAHP | R6(10) | Vishay | RCA060310R0FKEAHP | 507
53 | 1 | 3224W-1-203E | 20k, SMD Trimmer Potentiometer 0.25W Top Adjust Bourns, 3224 | 3224W-1-203E | R7(TRIM20KOHM) | Bourns | 3224W-1-203E | 78
54 | 1 | RA73F1J200RBTDF | Configuration Features: Number of Resistors 1 | Dimensions: Product Width .8 MM | Product Height .43 MM | Product Length 1.55 MM | Product Length .061 INCH | Product Width .031 INCH | Product Height .017 INCH | Electrical Characteristics: Power Rating .5 WATT | Resistance Value 200 OHM | Resistance Class Up to 1k | Passive Component Tolerance .1 PCT | Packaging Features: Packaging Method Tape & Reel | Product Type Features: Package Size Code 0630 | Element Type Thin Film | Resistor Type Precision Resistor |  | R8(200) |  |  | 513
55 | 1 | RA73F1J200RBTDF | Configuration Features: Number of Resistors 1 | Dimensions: Product Width .8 MM | Product Height .43 MM | Product Length 1.55 MM | Product Length .061 INCH | Product Width .031 INCH | Product Height .017 INCH | Electrical Characteristics: Power Rating .5 WATT | Resistance Value 200 OHM | Resistance Class Up to 1k | Passive Component Tolerance .1 PCT | Packaging Features: Packaging Method Tape & Reel | Product Type Features: Package Size Code 0630 | Element Type Thin Film | Resistor Type Precision Resistor |  | R9(200) |  |  | 510
56 | 1 | ERJUP6D1300V | Anti-Sulfurated Thick Film Chip Resistors/ Anti-Surge Type, Power Rating (W): 0.5, Chip Size (LxW(EIA)) (mm): 2.0 x 1.25 (EIA:0805), Resistance Values (?): 130, Resistance Tolerance (%): 0.5, T.C.R (10??/K): +/-100 | ERJUP6D1300V | R10(130OHM) | Panasonic | ERJUP6D1300V | 226
57 | 1 | P0603E50R0BBT | Thin Film Resistors - SMD .125watts 50ohms .1% 25ppm | P0603E50R0BBT | R11(50OHM) | Vishay | P0603E50R0BBT | 689
58 | 1 | R12-150B | Recom 5W Isolated DC-DC Converter, Vin 10 14 V dc, Vout 95 210V dc, I/O isolation 3000V dc | R12-150B | R12_150B |  |  | 200
59 | 1 | MCT06030C4020FP500 | Thin Film Resistors - SMD MCT 0603-50 1% P5 402R | (R_402_ohm)MCT06030C4020FP500 | R12(402) |  |  | 692
60 | 1 | ERJ3RED27R0V | Panasonic Thick Film Surface Mount Resistor 0603 Case 27 +/-0.5% 0.1W +/-100ppm/C | (R_27_ohm0603)ERJ3RED27R0V | R13(27) | Panasonic | ERJ3RED27R0V | 531
61 | 1 | 3224W-1-203E | 20k, SMD Trimmer Potentiometer 0.25W Top Adjust Bourns, 3224 | 3224W-1-203E | R15(TRIM20KOHM) | Bourns | 3224W-1-203E | 121
62 | 1 | RA73F1J200RBTDF | Configuration Features: Number of Resistors 1 | Dimensions: Product Width .8 MM | Product Height .43 MM | Product Length 1.55 MM | Product Length .061 INCH | Product Width .031 INCH | Product Height .017 INCH | Electrical Characteristics: Power Rating .5 WATT | Resistance Value 200 OHM | Resistance Class Up to 1k | Passive Component Tolerance .1 PCT | Packaging Features: Packaging Method Tape & Reel | Product Type Features: Package Size Code 0630 | Element Type Thin Film | Resistor Type Precision Resistor |  | R16(200) |  |  | 538
63 | 1 | ERJS03F1300V | 130 0603 Thick Film Surface Mount Resistor +/-1% 0.1W ERJS03F1300V |  | R17(130) |  |  | 544
64 | 1 | CRCW0603100RFKEC | VISHAY - CRCW0603100RFKEC - RES, AEC-Q200, THICK FILM, 100R, 0603 |  | R18(100) |  |  | 574
65 | 1 | RC0603JR-070RL | YAGEO (PHYCOMP) - RC0603JR-070RL - RES, THICK FILM, 0R, 5%, 0.1W, 0603 |  | R19(0) |  |  | 559
66 | 1 | RC0603JR-070RL | YAGEO (PHYCOMP) - RC0603JR-070RL - RES, THICK FILM, 0R, 5%, 0.1W, 0603 |  | R20(0) |  |  | 562
67 | 1 | 3224W-1-203E | 20k, SMD Trimmer Potentiometer 0.25W Top Adjust Bourns, 3224 | 3224W-1-203E | R21(TRIM20KOHM) | Bourns | 3224W-1-203E | 146
68 | 1 | RA73F1J200RBTDF | Configuration Features: Number of Resistors 1 | Dimensions: Product Width .8 MM | Product Height .43 MM | Product Length 1.55 MM | Product Length .061 INCH | Product Width .031 INCH | Product Height .017 INCH | Electrical Characteristics: Power Rating .5 WATT | Resistance Value 200 OHM | Resistance Class Up to 1k | Passive Component Tolerance .1 PCT | Packaging Features: Packaging Method Tape & Reel | Product Type Features: Package Size Code 0630 | Element Type Thin Film | Resistor Type Precision Resistor |  | R22(200) |  |  | 541
69 | 1 | ERJS03F1300V | 130 0603 Thick Film Surface Mount Resistor +/-1% 0.1W ERJS03F1300V |  | R23(130) |  |  | 547
70 | 1 | P0603E50R0BBT | Thin Film Resistors - SMD .125watts 50ohms .1% 25ppm | P0603E50R0BBT | R24(50OHM) | Vishay | P0603E50R0BBT | 238
71 | 1 | CRCW0603100RFKEC | VISHAY - CRCW0603100RFKEC - RES, AEC-Q200, THICK FILM, 100R, 0603 |  | R25(100) |  |  | 571
72 | 1 | RC0603JR-070RL | YAGEO (PHYCOMP) - RC0603JR-070RL - RES, THICK FILM, 0R, 5%, 0.1W, 0603 |  | R26(0) |  |  | 565
73 | 1 | RC0603JR-070RL | YAGEO (PHYCOMP) - RC0603JR-070RL - RES, THICK FILM, 0R, 5%, 0.1W, 0603 |  | R27(0) |  |  | 568
74 | 1 | TLV3604DCKR | 800-ps high-speed rail-rail input comparator with LVDS outputs | TLV3604DCKR | TLV3604_1 | Texas Instruments | TLV3604DCKR | 216
75 | 1 | TLV3604DCKR | 800-ps high-speed rail-rail input comparator with LVDS outputs | TLV3604DCKR | TLV3604_2 | Texas Instruments | TLV3604DCKR | 405
76 | 1 | TSW-110-07-G-D | 20 Position, Classic PCB Header Strips, 0.100&quot; pitch | TSW-110-07-G-D | TSW11007GD | SAMTEC | TSW-110-07-G-D | 696
