sky9464881/tof-lidar-receiver-design/simulation/project_backups/revised_receiver_project_backup/new_lidar/new_lidar_output/bom.sch.csv

Item Number | Quantity | Value | Description | Part Number | Part Reference | Manufacturer Name | Manufacturer Part Number | ID | SKU | ALT_MPN | ALT_MFR
1 | 1 | 6.8uF |  |  | C1 |  |  | 6
2 | 1 | 0.47uF |  |  | C2 |  |  | 3
3 | 1 | CBR08C508ACGAC | CBR-SMD RF C0G, Ceramic, 0.5 pF, +/-0.05 pF, 500 VDC, 750 VDC, 125C, -55C, C0G, SMD, Fixed, RF, Ultra High Q, Low ESR, Class I, 0.24 % , 10 GOhms, 410, 10.7 mg, 0805, 2mm, 1.25mm, 0.85mm, 0.5mm, 4000, 78 Weeks, 120 | (0.5pF)CBR08C508ACGAC | C2(0.5PF) |  |  | 2330
4 | 1 | C3216X7R2A474K160AA | TDK C3216 C 470nF Ceramic Multilayer Capacitor, 100 V dc, +125C, X7R Dielectric, +/-10% SMD | C3216X7R2A474K160AA | C3(0.47UF)1 | TDK | C3216X7R2A474K160AA | 1893
5 | 1 | C3216X7R2A474K160AA | TDK C3216 C 470nF Ceramic Multilayer Capacitor, 100 V dc, +125C, X7R Dielectric, +/-10% SMD | C3216X7R2A474K160AA | C3(0.47UF)2 | TDK | C3216X7R2A474K160AA | 1924
6 | 1 | 0.47uF |  |  | C7 |  |  | 21
7 | 1 | C0603G104K5RACT250 | SMD Indust X7R HT175C, Ceramic, 0.1 uF, 10%, 50 VDC, 125 VDC, 175C, -55C, X7R, SMD, MLCC, High Temperature, Class II, 2.5 % , 5 GOhms, 4.8 mg, 0603, 1.6mm, 0.8mm, 0.8mm, 0.7mm, 0.35mm, 250, 78 Weeks, 80 | C0603G104K5RACT250 | C9(0.1UF) | KEMET | C0603G104K5RACT250 | 2040
8 | 1 | C0603G104K5RACT250 | SMD Indust X7R HT175C, Ceramic, 0.1 uF, 10%, 50 VDC, 125 VDC, 175C, -55C, X7R, SMD, MLCC, High Temperature, Class II, 2.5 % , 5 GOhms, 4.8 mg, 0603, 1.6mm, 0.8mm, 0.8mm, 0.7mm, 0.35mm, 250, 78 Weeks, 80 | C0603G104K5RACT250 | C10(0.1UF) | KEMET | C0603G104K5RACT250 | 2022
9 | 1 | 0.5pF |  |  | C12 |  |  | 427
10 | 1 | C0603G104K5RACT250 | SMD Indust X7R HT175C, Ceramic, 0.1 uF, 10%, 50 VDC, 125 VDC, 175C, -55C, X7R, SMD, MLCC, High Temperature, Class II, 2.5 % , 5 GOhms, 4.8 mg, 0603, 1.6mm, 0.8mm, 0.8mm, 0.7mm, 0.35mm, 250, 78 Weeks, 80 | C0603G104K5RACT250 | C14(0.1UF) | KEMET | C0603G104K5RACT250 | 2053
11 | 1 | C0603G104K5RACT250 | SMD Indust X7R HT175C, Ceramic, 0.1 uF, 10%, 50 VDC, 125 VDC, 175C, -55C, X7R, SMD, MLCC, High Temperature, Class II, 2.5 % , 5 GOhms, 4.8 mg, 0603, 1.6mm, 0.8mm, 0.8mm, 0.7mm, 0.35mm, 250, 78 Weeks, 80 | C0603G104K5RACT250 | C16(0.1UF) | KEMET | C0603G104K5RACT250 | 2072
12 | 1 | C3216X5R2J102M115AA | MULTILAYER CERAMIC CHIP CAPACITORS, 3216, Commercial grade, general (Up to 75V) | C3216X5R2J102M115AA | C17(1NF) | TDK | C3216X5R2J102M115AA | 2069
13 | 1 | C3216X5R2J102M115AA | MULTILAYER CERAMIC CHIP CAPACITORS, 3216, Commercial grade, general (Up to 75V) | C3216X5R2J102M115AA | C17(1NF)1 | TDK | C3216X5R2J102M115AA | 2087
14 | 1 | C0603G104K5RACT250 | SMD Indust X7R HT175C, Ceramic, 0.1 uF, 10%, 50 VDC, 125 VDC, 175C, -55C, X7R, SMD, MLCC, High Temperature, Class II, 2.5 % , 5 GOhms, 4.8 mg, 0603, 1.6mm, 0.8mm, 0.8mm, 0.7mm, 0.35mm, 250, 78 Weeks, 80 | C0603G104K5RACT250 | C18(0.1UF) | KEMET | C0603G104K5RACT250 | 2106
15 | 1 | C3216X5R2J102M115AA | MULTILAYER CERAMIC CHIP CAPACITORS, 3216, Commercial grade, general (Up to 75V) | C3216X5R2J102M115AA | C19(1NF) | TDK | C3216X5R2J102M115AA | 2128
16 | 1 | C0603G104K5RACT250 | SMD Indust X7R HT175C, Ceramic, 0.1 uF, 10%, 50 VDC, 125 VDC, 175C, -55C, X7R, SMD, MLCC, High Temperature, Class II, 2.5 % , 5 GOhms, 4.8 mg, 0603, 1.6mm, 0.8mm, 0.8mm, 0.7mm, 0.35mm, 250, 78 Weeks, 80 | C0603G104K5RACT250 | C20(0.1UF) | KEMET | C0603G104K5RACT250 | 2100
17 | 1 | TAJA685K020R | AVX 6.8uF SMD Solid MnO2 Tantalum Electrolytic Capacitor, 20 V dc +/-10%, TAJ Series | TAJA685K020R | C22(6.8UF)1 | Kyocera AVX | TAJA685K020R | 2154
18 | 1 | TAJA685K020R | AVX 6.8uF SMD Solid MnO2 Tantalum Electrolytic Capacitor, 20 V dc +/-10%, TAJ Series | TAJA685K020R | C22(6.8UF) | Kyocera AVX | TAJA685K020R | 2125
19 | 1 | C0603G104K5RACT250 | SMD Indust X7R HT175C, Ceramic, 0.1 uF, 10%, 50 VDC, 125 VDC, 175C, -55C, X7R, SMD, MLCC, High Temperature, Class II, 2.5 % , 5 GOhms, 4.8 mg, 0603, 1.6mm, 0.8mm, 0.8mm, 0.7mm, 0.35mm, 250, 78 Weeks, 80 | C0603G104K5RACT250 | C23(0.1UF) | KEMET | C0603G104K5RACT250 | 2037
20 | 1 | C3216X5R2J102M115AA | MULTILAYER CERAMIC CHIP CAPACITORS, 3216, Commercial grade, general (Up to 75V) | C3216X5R2J102M115AA | C24(1NF) | TDK | C3216X5R2J102M115AA | 2009
21 | 1 | TAJA685K020R | AVX 6.8uF SMD Solid MnO2 Tantalum Electrolytic Capacitor, 20 V dc +/-10%, TAJ Series | TAJA685K020R | C26(6.8UF)1 | Kyocera AVX | TAJA685K020R | 2134
22 | 1 | TAJA685K020R | AVX 6.8uF SMD Solid MnO2 Tantalum Electrolytic Capacitor, 20 V dc +/-10%, TAJ Series | TAJA685K020R | C26(6.8UF) | Kyocera AVX | TAJA685K020R | 1918
23 | 1 | C0603G104K5RACT250 | SMD Indust X7R HT175C, Ceramic, 0.1 uF, 10%, 50 VDC, 125 VDC, 175C, -55C, X7R, SMD, MLCC, High Temperature, Class II, 2.5 % , 5 GOhms, 4.8 mg, 0603, 1.6mm, 0.8mm, 0.8mm, 0.7mm, 0.35mm, 250, 78 Weeks, 80 | C0603G104K5RACT250 | C30(0.1UF) | KEMET | C0603G104K5RACT250 | 2240
24 | 1 | C0603G104K5RACT250 | SMD Indust X7R HT175C, Ceramic, 0.1 uF, 10%, 50 VDC, 125 VDC, 175C, -55C, X7R, SMD, MLCC, High Temperature, Class II, 2.5 % , 5 GOhms, 4.8 mg, 0603, 1.6mm, 0.8mm, 0.8mm, 0.7mm, 0.35mm, 250, 78 Weeks, 80 | C0603G104K5RACT250 | C30(0.1UF)2 | KEMET | C0603G104K5RACT250 | 2225
25 | 1 | C0603G104K5RACT250 | SMD Indust X7R HT175C, Ceramic, 0.1 uF, 10%, 50 VDC, 125 VDC, 175C, -55C, X7R, SMD, MLCC, High Temperature, Class II, 2.5 % , 5 GOhms, 4.8 mg, 0603, 1.6mm, 0.8mm, 0.8mm, 0.7mm, 0.35mm, 250, 78 Weeks, 80 | C0603G104K5RACT250 | C30(0.1UF)1 | KEMET | C0603G104K5RACT250 | 2222
26 | 1 | C3216X5R2J102M115AA | MULTILAYER CERAMIC CHIP CAPACITORS, 3216, Commercial grade, general (Up to 75V) | C3216X5R2J102M115AA | C31(1NF)5 | TDK | C3216X5R2J102M115AA | 2219
27 | 1 | C3216X5R2J102M115AA | MULTILAYER CERAMIC CHIP CAPACITORS, 3216, Commercial grade, general (Up to 75V) | C3216X5R2J102M115AA | C31(1NF)1 | TDK | C3216X5R2J102M115AA | 2237
28 | 1 | C3216X5R2J102M115AA | MULTILAYER CERAMIC CHIP CAPACITORS, 3216, Commercial grade, general (Up to 75V) | C3216X5R2J102M115AA | C31(1NF)4 | TDK | C3216X5R2J102M115AA | 2081
29 | 1 | C3216X5R2J102M115AA | MULTILAYER CERAMIC CHIP CAPACITORS, 3216, Commercial grade, general (Up to 75V) | C3216X5R2J102M115AA | C31(1NF)3 | TDK | C3216X5R2J102M115AA | 2228
30 | 1 | C3216X5R2J102M115AA | MULTILAYER CERAMIC CHIP CAPACITORS, 3216, Commercial grade, general (Up to 75V) | C3216X5R2J102M115AA | C31(1NF) | TDK | C3216X5R2J102M115AA | 2216
31 | 1 | C3216X5R2J102M115AA | MULTILAYER CERAMIC CHIP CAPACITORS, 3216, Commercial grade, general (Up to 75V) | C3216X5R2J102M115AA | C31(1NF)2 | TDK | C3216X5R2J102M115AA | 2260
32 | 1 | C0603G104K5RACT250 | SMD Indust X7R HT175C, Ceramic, 0.1 uF, 10%, 50 VDC, 125 VDC, 175C, -55C, X7R, SMD, MLCC, High Temperature, Class II, 2.5 % , 5 GOhms, 4.8 mg, 0603, 1.6mm, 0.8mm, 0.8mm, 0.7mm, 0.35mm, 250, 78 Weeks, 80 | C0603G104K5RACT250 | C37(0.1UF) | KEMET | C0603G104K5RACT250 | 2234
33 | 1 | C3216X5R2J102M115AA | MULTILAYER CERAMIC CHIP CAPACITORS, 3216, Commercial grade, general (Up to 75V) | C3216X5R2J102M115AA | C38(1NF) | TDK | C3216X5R2J102M115AA | 2253
34 | 1 | TAJA685K020R | AVX 6.8uF SMD Solid MnO2 Tantalum Electrolytic Capacitor, 20 V dc +/-10%, TAJ Series | TAJA685K020R | C40(6.8UF) | Kyocera AVX | TAJA685K020R | 2186
35 | 1 | 0.1uF |  |  | C49 |  |  | 153
36 | 1 | 0.1uF |  |  | C50 |  |  | 140
37 | 1 | 10nF |  |  | C52 |  |  | 185
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
113 | 1 | 0.1u |  |  | C298 |  |  | 1756
114 | 1 | 1n |  |  | C299 |  |  | 1863
115 | 1 | 0.1uF |  |  | C300 |  |  | 1786
116 | 1 | 1n |  |  | C301 |  |  | 1857
117 | 1 | 6.8u |  |  | C302 |  |  | 1762
118 | 1 | 1nF |  |  | C303 |  |  | 1795
119 | 1 | 1n |  |  | C304 |  |  | 1759
120 | 1 | 0.1uF |  |  | C305 |  |  | 1801
121 | 1 | 0.1uF |  |  | C306 |  |  | 1844
122 | 1 | 1n |  |  | C307 |  |  | 1753
123 | 1 | 1nF |  |  | C308 |  |  | 1765
124 | 1 | 6.8uF |  |  | C309 |  |  | 1750
125 | 1 | 0.1uF |  |  | C310 |  |  | 1826
126 | 1 | 1n |  |  | C311 |  |  | 1774
127 | 1 | 1n |  |  | C312 |  |  | 1717
128 | 1 | 0.1uF |  |  | C313 |  |  | 1814
129 | 1 | 1n |  |  | C314 |  |  | 1847
130 | 1 | 1nF |  |  | C315 |  |  | 2299
131 | 1 | C3216X5R2J102M115AA | MULTILAYER CERAMIC CHIP CAPACITORS, 3216, Commercial grade, general (Up to 75V) | (1nF)C3216X5R2J102M115AA | C315(1NF) | TDK | C3216X5R2J102M115AA | 2291
132 | 1 | C3216X5R2J102M115AA | MULTILAYER CERAMIC CHIP CAPACITORS, 3216, Commercial grade, general (Up to 75V) | (1nF)C3216X5R2J102M115AA | C315(1NF)1 | TDK | C3216X5R2J102M115AA | 2294
133 | 1 | 1nF |  |  | C316 |  |  | 2305
134 | 1 | OPA855IDSGR | High Speed Operational Amplifiers 8 GHz Gain Bandwidth Product, Decompensated Transimpedance Amplifier with Bipolar Input 8-WSON -40 to 125 | OPA855IDSGR | IC1 | Texas Instruments | OPA855IDSGR | 2012
135 | 1 | OPA277U_2K5 | High Precision Operational Amplifiers | OPA277U/2K5 | IC2 | Texas Instruments | OPA277U/2K5 | 2060
136 | 1 | OPA277U_2K5 | High Precision Operational Amplifiers | OPA277U/2K5 | IC3 | Texas Instruments | OPA277U/2K5 | 2263
137 | 1 | OPA277U_2K5 | High Precision Operational Amplifiers | OPA277U/2K5 | IC4 | Texas Instruments | OPA277U/2K5 | 2272
138 | 1 | OPA855IDSGR | High Speed Operational Amplifiers 8 GHz Gain Bandwidth Product, Decompensated Transimpedance Amplifier with Bipolar Input 8-WSON -40 to 125 |  | IC9 |  |  | 436
139 | 1 | LM2940T-5.0_NOPB | Texas Instruments LM2940T-5.0/NOPB, LDO Voltage Regulator, 1A, 5 V, 6.25 26 Vin 3-Pin, TO-220 | LM2940T-5.0/NOPB | IC11 | Texas Instruments | LM2940T-5.0/NOPB | 1903
140 | 1 | LM2990T-5.0_NOPB | Texas Instruments LM2990T-5.0/NOPB, LDO Voltage Regulator, 1A, -5 V +/-5%, -26 0.3 Vin, 3-Pin TO-220 | LM2990T-5.0/NOPB | IC12 | Texas Instruments | LM2990T-5.0/NOPB | 1899
141 | 1 | OPA695IDBVR | Ultra-Wideband, Current-Feedback Operational Amplifier with Disable | OPA695IDBVR | IC13 | Texas Instruments | OPA695IDBVR | 2118
142 | 1 | TLV3604DCKR | 800-ps high-speed rail-rail input comparator with LVDS outputs | TLV3604DCKR | IC14 | Texas Instruments | TLV3604DCKR | 2176
143 | 1 | TLV3604DCKR | 800-ps high-speed rail-rail input comparator with LVDS outputs | TLV3604DCKR | IC15 | Texas Instruments | TLV3604DCKR | 2157
144 | 1 | TSW-110-07-G-D | 20 Position, Classic PCB Header Strips, 0.100&quot; pitch | TSW-110-07-G-D | J1 | SAMTEC | TSW-110-07-G-D | 770
145 | 1 | 4 HEADER |  |  | J2 |  |  | 1913
146 | 1 | TSW-110-07-G-D | 20 Position, Classic PCB Header Strips, 0.100&quot; pitch | TSW-110-07-G-D | J3 | SAMTEC | TSW-110-07-G-D | 1984
147 | 1 | 4 HEADER |  |  | JP1 |  |  | 9
148 | 1 | R12-150B | Recom 5W Isolated DC-DC Converter, Vin 10 14 V dc, Vout 95 210V dc, I/O isolation 3000V dc | R12-150B | PS1 |  |  | 1930
149 | 1 | TNPW0603200KBEEA | Vishay TNPW Series Thin Film Surface Mount Resistor 0603 Case 200k +/-0.1% 0.1W +/-25ppm/K | TNPW0603200KBEEA | R4(200K) | Vishay | TNPW0603200KBEEA | 2043
150 | 1 | CRCW201010R0JNEFIF | 10 Ohms +/-5% 0.75W, 3/4W Chip Resistor 2010 (5025 Metric) Automotive AEC-Q200, Pulse Withstanding Thick Film | CRCW201010R0JNEFIF | R6(10OHM)1 | Vishay | CRCW201010R0JNEFIF | 1907
151 | 1 | CRCW201010R0JNEFIF | 10 Ohms +/-5% 0.75W, 3/4W Chip Resistor 2010 (5025 Metric) Automotive AEC-Q200, Pulse Withstanding Thick Film | CRCW201010R0JNEFIF | R6(10OHM)2 | Vishay | CRCW201010R0JNEFIF | 2025
152 | 1 | CRCW201010R0JNEFIF | 10 Ohms +/-5% 0.75W, 3/4W Chip Resistor 2010 (5025 Metric) Automotive AEC-Q200, Pulse Withstanding Thick Film | CRCW201010R0JNEFIF | R6(10OHM) | Vishay | CRCW201010R0JNEFIF | 1896
153 | 1 | CRCW0402200RFKEDHP | Thick Film Resistors - SMD 0.2W 200ohms 1% High Power AEC-Q200 | CRCW0402200RFKEDHP | R8(200OHM)1 | Vishay | CRCW0402200RFKEDHP | 2078
154 | 1 | CRCW0402200RFKEDHP | Thick Film Resistors - SMD 0.2W 200ohms 1% High Power AEC-Q200 | CRCW0402200RFKEDHP | R8(200OHM) | Vishay | CRCW0402200RFKEDHP | 2075
155 | 1 | ERJUP6D1300V | Anti-Sulfurated Thick Film Chip Resistors/ Anti-Surge Type, Power Rating (W): 0.5, Chip Size (LxW(EIA)) (mm): 2.0 x 1.25 (EIA:0805), Resistance Values (?): 130, Resistance Tolerance (%): 0.5, T.C.R (10??/K): +/-100 | ERJUP6D1300V | R9(130OHM) | Panasonic | ERJUP6D1300V | 2084
156 | 1 | KTR03EZPF3600 | Thick Film Resistors - SMD 0603 360ohm 1% High Voltage | KTR03EZPF3600 | R9(360OHM) | ROHM Semiconductor | KTR03EZPF3600 | 2137
157 | 1 | CRCW120620R0FKEAHP | Vishay CRCW Series Thick Film High Power Surface Mount Resistor 1206 Case 20 +/-1% 0.5W +/-100ppm/K | CRCW120620R0FKEAHP | R10(20OHM) | Vishay | CRCW120620R0FKEAHP | 2103
158 | 1 | MCA12060D5000BP500 | 500 Ohms +/-0.1% 0.25W, 1/4W Chip Resistor 1206 (3216 Metric) Anti-Sulfur Thin Film | MCA12060D5000BP500 | R11(500OHM) | Vishay | MCA12060D5000BP500 | 2031
159 | 1 | MCA12060D5000BP500 | 500 Ohms +/-0.1% 0.25W, 1/4W Chip Resistor 1206 (3216 Metric) Anti-Sulfur Thin Film | MCA12060D5000BP500 | R11(500OHM)1 | Vishay | MCA12060D5000BP500 | 2109
160 | 1 | WSC251527R00FEA | Wirewound Resistors - SMD 1watt 27ohms 1% | WSC251527R00FEA | R12(27OHM) | Vishay | WSC251527R00FEA | 2097
161 | 1 | CRCW0402200RFKEDHP | Thick Film Resistors - SMD 0.2W 200ohms 1% High Power AEC-Q200 | CRCW0402200RFKEDHP | R15(200OHM) | Vishay | CRCW0402200RFKEDHP | 2246
162 | 1 | RC0603JR-070RL | Yageo 0, 0603 (1608M) Thick Film SMD Resistor - RC0603JR-070RL | RC0603JR-070RL | R17(0OHM) | YAGEO | RC0603JR-070RL | 2195
163 | 1 | ERJ-1GJF1000C | Series/Type: Precision Thick Film Chip Resistors, Power Rating (W): 0.05, Chip Size (LxW(EIA)) (mm): 0.6 x 0.3 (EIA:0201), Resistance Values (): 100, Resistance Tolerance (%): 1, T.C.R (10/K): +/-200 | ERJ-1GJF1000C | R18(100OHM) | Panasonic | ERJ-1GJF1000C | 2183
164 | 1 | RC0603JR-070RL | Yageo 0, 0603 (1608M) Thick Film SMD Resistor - RC0603JR-070RL | RC0603JR-070RL | R19(0OHM) | YAGEO | RC0603JR-070RL | 2167
165 | 1 | CRCW0402200RFKEDHP | Thick Film Resistors - SMD 0.2W 200ohms 1% High Power AEC-Q200 | CRCW0402200RFKEDHP | R21(200OHM) | Vishay | CRCW0402200RFKEDHP | 2243
166 | 1 | P0603E50R0BBT | Thin Film Resistors - SMD .125watts 50ohms .1% 25ppm | P0603E50R0BBT | R23(50OHM) | Vishay | P0603E50R0BBT | 2192
167 | 1 | RC0603JR-070RL | Yageo 0, 0603 (1608M) Thick Film SMD Resistor - RC0603JR-070RL | RC0603JR-070RL | R24(0OHM) | YAGEO | RC0603JR-070RL | 2170
168 | 1 | ERJ-1GJF1000C | Series/Type: Precision Thick Film Chip Resistors, Power Rating (W): 0.05, Chip Size (LxW(EIA)) (mm): 0.6 x 0.3 (EIA:0201), Resistance Values (): 100, Resistance Tolerance (%): 1, T.C.R (10/K): +/-200 | ERJ-1GJF1000C | R25(100OHM)1 | Panasonic | ERJ-1GJF1000C | 2164
169 | 1 | RC0603JR-070RL | Yageo 0, 0603 (1608M) Thick Film SMD Resistor - RC0603JR-070RL | RC0603JR-070RL | R26(0OHM) | YAGEO | RC0603JR-070RL | 2173
170 | 1 | 200 |  |  | R60 |  |  | 104
171 | 1 | 20 k |  |  | R61 |  |  | 163
172 | 1 | 100 |  |  | R62 |  |  | 160
173 | 1 | 200 |  |  | R63 |  |  | 201
174 | 1 | 200k |  |  | R73 |  |  | 424
175 | 1 | 500 |  |  | R74 |  |  | 449
176 | 1 | 200 |  |  | R77 |  |  | 430
177 | 1 | 20 k |  |  | R78 |  |  | 417
178 | 1 | 130 |  |  | R80 |  |  | 528
179 | 1 | 500 |  |  | R114 |  |  | 586
180 | 1 | 360 |  |  | R117 |  |  | 607
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
259 | 1 | TLV3604 |  |  | U81 |  |  | 1669
260 | 1 | OPAx277 |  |  | U82 |  |  | 1630
261 | 1 | OPA855 |  |  | U83 |  |  | 1693
262 | 1 | OPA695 |  |  | U84 |  |  | 1835
263 | 1 | OPAx277 |  |  | U85 |  |  | 1780
264 | 1 | TLV3604 |  |  | U86 |  |  | 1850
265 | 1 | OPAx277 |  |  | U87 |  |  | 1732
266 | 1 | MTAPD-06-013 | SENSOR PHOTODIODE 905NM TO46-2 | MTAPD-06-013 | U88 | Marktech Optoelectronics | MTAPD-06-013 | 2028
267 | 1 | TS7Y502KR32 | 5 kOhms 0.5W, 1/2W Gull Wing Surface Mount Trimmer Potentiometer Cermet 1.0 Turn Top Adjustment | TS7Y502KR32 | VR1 | Vishay | TS7Y502KR32 | 1946
