sky9464881/tof-lidar-receiver-design/simulation/block_tests/opa277/opa277_output/bom.sch.csv

Item Number | Quantity | Value | Description | Part Number | Part Reference | Manufacturer Name | Manufacturer Part Number | ID | SKU | ALT_MPN | ALT_MFR
1 | 1 | 0.1uF |  |  | C250 |  |  | 95
2 | 1 | 6.8uF |  |  | C251 |  |  | 92
3 | 1 | 0.1uF |  |  | C252 |  |  | 70
4 | 1 | 0.1uF |  |  | C253 |  |  | 76
5 | 1 | 0.1uF |  |  | C254 |  |  | 82
6 | 1 | 200 |  |  | R145 |  |  | 88
7 | 1 | 200 |  |  | R146 |  |  | 79
8 | 1 | 10k |  |  | R147 |  |  | 101
9 | 1 | 10k |  |  | R148 |  |  | 98
10 | 1 | OPAx277 |  |  | U1 |  |  | 3
