sky9464881/tof-lidar-receiver-design/simulation/block_tests/opa277/opa277_output/srceng.bom.sch.csv

Quantity | Part Number | Part Reference | Value | Description | Manufacturer Name | Manufacturer Part Number
1 |  | C250 | 0.1uF
1 |  | C251 | 6.8uF
1 |  | C252 | 0.1uF
1 |  | C253 | 0.1uF
1 |  | C254 | 0.1uF
1 |  | R145 | 200
1 |  | R146 | 200
1 |  | R147 | 10k
1 |  | R148 | 10k
1 |  | U1 | OPAx277
