sky9464881/tof-lidar-receiver-design/simulation/block_tests/opa695/opa695_output/srceng.bom.sch.csv

Quantity | Part Number | Part Reference | Value | Description | Manufacturer Name | Manufacturer Part Number
1 |  | C253 | 0.1uF
1 |  | C254 | 6.8uF
1 |  | C255 | 0.1uF
1 |  | C256 | 6.8uF
1 |  | C257 | 0.1u
1 |  | C258 | 1n
1 |  | C259 | 0.1uF
1 |  | R152 | 402
1 |  | R155 | 50
1 |  | R156 | 27
1 |  | R157 | 67k
1 |  | U73 | OPA695
