sky9464881/tof-lidar-receiver-design/(list of files, cad)

Other CAD files:
design/footprint_library/footprint/con20a_100mil.psm
design/footprint_library/footprint/dip20_3.psm
design/footprint_library/footprint/header4.psm
design/footprint_library/footprint/lm2940_to220.psm
design/footprint_library/footprint/lm2990_to220ab.psm
design/footprint_library/footprint/opa277.psm
design/footprint_library/footprint/qfn50p300x300x100-17n-d.psm
design/footprint_library/footprint/qfn50p300x300x100-17n-d_2.psm
design/footprint_library/footprint/r12_150.psm
design/footprint_library/footprint/rfsmav.psm
design/footprint_library/footprint/sc70_6pin.psm
design/footprint_library/footprint/smc0603.psm
design/footprint_library/footprint/smc1608.psm
design/footprint_library/footprint/smc2012.psm
design/footprint_library/footprint/smc321612.psm
design/footprint_library/footprint/smc603212.psm
design/footprint_library/footprint/smc734312.psm
design/footprint_library/footprint/smd_sod123.psm
design/footprint_library/footprint/sml3216.psm
design/footprint_library/footprint/smr1608.psm
design/footprint_library/footprint/smr3216.psm
design/footprint_library/footprint/soic8.psm
design/footprint_library/footprint/son50p200x200x80-9n-d.psm
design/footprint_library/footprint/sot95p280x145-5n.psm
design/footprint_library/footprint/st5ew.psm
design/footprint_library/footprint/to46_2pin.psm
design/footprint_library/mtapd/lcc3_smd.psm
design/pcb/allegro/symbols_chan/header4.psm
design/pcb/allegro/symbols_chan/lcc3_smd.psm
design/pcb/allegro/symbols_chan/lm2940_to220.psm
design/pcb/allegro/symbols_chan/lm2990_to220ab.psm
design/pcb/allegro/symbols_chan/opa277.psm
design/pcb/allegro/symbols_chan/qfn50p300x300x100-17n-d.psm
design/pcb/allegro/symbols_chan/r12_150.psm
design/pcb/allegro/symbols_chan/rfsmav.psm
design/pcb/allegro/symbols_chan/smc1608.psm
design/pcb/allegro/symbols_chan/smc2012.psm
design/pcb/allegro/symbols_chan/smc321612.psm
design/pcb/allegro/symbols_chan/smc603212.psm
design/pcb/allegro/symbols_chan/smr1005.psm
design/pcb/allegro/symbols_chan/smr1608.psm
design/pcb/allegro/symbols_chan/smr3216.psm
design/pcb/allegro/symbols_chan/soic127p600x175-8n.psm
design/pcb/allegro/symbols_chan/soic8.psm
design/pcb/allegro/symbols_chan/son50p200x200x80-9n.psm
design/pcb/allegro/symbols_chan/sot95p280x145-5n.psm
design/pcb/allegro/symbols_chan/st5ew.psm
simulation/pspice_main/main_pcb_project/allegro/4header.psm
simulation/pspice_main/main_pcb_project/allegro/bourns_4606m-901-103lf-b.psm
