sky9464881/tof-lidar-receiver-design/results/archived/capstone_final/6.2/6.2 final opa695/6.2 final opa695_100  compartor 0 lowpass 5.6pF/att=3.0/att=3.0_00001.csv

-1.834791E-08 | 2.558E-02
-1.829791E-08 | 2.298E-02
-1.824791E-08 | 2.193E-02
-1.819791E-08 | 1.932E-02
-1.814791E-08 | 1.776E-02
-1.809791E-08 | 1.619E-02
-1.804791E-08 | 1.359E-02
-1.799791E-08 | 1.202E-02
-1.794791E-08 | 1.046E-02
-1.789791E-08 | 8.37E-03
-1.784791E-08 | 7.33E-03
-1.779791E-08 | 5.24E-03
-1.774791E-08 | 4.20E-03
-1.769791E-08 | 3.15E-03
-1.764791E-08 | 3.15E-03
-1.759791E-08 | 2.11E-03
-1.754791E-08 | 1.59E-03
-1.749791E-08 | 1.59E-03
-1.744791E-08 | 1.59E-03
-1.739791E-08 | 2.11E-03
-1.734791E-08 | 2.11E-03
-1.729791E-08 | 2.11E-03
-1.724791E-08 | 3.68E-03
-1.719791E-08 | 3.15E-03
-1.714791E-08 | 4.20E-03
-1.709791E-08 | 5.24E-03
-1.704791E-08 | 5.76E-03
-1.699791E-08 | 6.81E-03
-1.694791E-08 | 8.37E-03
-1.689791E-08 | 8.89E-03
-1.684791E-08 | 9.93E-03
-1.679791E-08 | 1.098E-02
-1.674791E-08 | 1.150E-02
-1.669791E-08 | 1.254E-02
-1.664791E-08 | 1.306E-02
-1.659791E-08 | 1.306E-02
-1.654791E-08 | 1.411E-02
-1.649791E-08 | 1.411E-02
-1.644791E-08 | 1.359E-02
-1.639791E-08 | 1.359E-02
-1.634791E-08 | 1.411E-02
-1.629791E-08 | 1.359E-02
-1.624791E-08 | 1.306E-02
-1.619791E-08 | 1.306E-02
-1.614791E-08 | 1.202E-02
-1.609791E-08 | 1.150E-02
-1.604791E-08 | 9.93E-03
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
