sky9464881/tof-lidar-receiver-design/results/archived/capstone_final/6.2/6.2 final opa695/6.2 final opa695_100  compartor 0 lowpass 5.6pF/att=3.0/att=3.0_00002.csv

-1.839220E-08 | 2.245E-02
-1.834220E-08 | 2.298E-02
-1.829220E-08 | 2.402E-02
-1.824220E-08 | 2.506E-02
-1.819220E-08 | 2.611E-02
-1.814220E-08 | 2.663E-02
-1.809220E-08 | 2.611E-02
-1.804220E-08 | 2.611E-02
-1.799220E-08 | 2.663E-02
-1.794220E-08 | 2.611E-02
-1.789220E-08 | 2.558E-02
-1.784220E-08 | 2.558E-02
-1.779220E-08 | 2.402E-02
-1.774220E-08 | 2.298E-02
-1.769220E-08 | 2.193E-02
-1.764220E-08 | 2.089E-02
-1.759220E-08 | 1.985E-02
-1.754220E-08 | 1.880E-02
-1.749220E-08 | 1.776E-02
-1.744220E-08 | 1.724E-02
-1.739220E-08 | 1.515E-02
-1.734220E-08 | 1.411E-02
-1.729220E-08 | 1.359E-02
-1.724220E-08 | 1.306E-02
-1.719220E-08 | 1.202E-02
-1.714220E-08 | 1.150E-02
-1.709220E-08 | 1.202E-02
-1.704220E-08 | 1.150E-02
-1.699220E-08 | 1.150E-02
-1.694220E-08 | 1.202E-02
-1.689220E-08 | 1.150E-02
-1.684220E-08 | 1.254E-02
-1.679220E-08 | 1.306E-02
-1.674220E-08 | 1.359E-02
-1.669220E-08 | 1.411E-02
-1.664220E-08 | 1.567E-02
-1.659220E-08 | 1.724E-02
-1.654220E-08 | 1.776E-02
-1.649220E-08 | 1.880E-02
-1.644220E-08 | 1.985E-02
-1.639220E-08 | 2.141E-02
-1.634220E-08 | 2.193E-02
-1.629220E-08 | 2.298E-02
-1.624220E-08 | 2.454E-02
-1.619220E-08 | 2.558E-02
-1.614220E-08 | 2.611E-02
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
