sky9464881/tof-lidar-receiver-design/results/archived/capstone_final/6.2/6.2 final opa695/6.2 final opa695_100  compartor 0 lowpass 5.6pF/att=3.0/att=3.0_00003.csv

-1.838531E-08 | 1.463E-02
-1.833531E-08 | 1.463E-02
-1.828531E-08 | 1.306E-02
-1.823531E-08 | 1.254E-02
-1.818531E-08 | 1.150E-02
-1.813531E-08 | 1.098E-02
-1.808531E-08 | 9.41E-03
-1.803531E-08 | 9.41E-03
-1.798531E-08 | 8.89E-03
-1.793531E-08 | 8.37E-03
-1.788531E-08 | 8.37E-03
-1.783531E-08 | 7.33E-03
-1.778531E-08 | 7.33E-03
-1.773531E-08 | 7.33E-03
-1.768531E-08 | 7.33E-03
-1.763531E-08 | 7.33E-03
-1.758531E-08 | 7.33E-03
-1.753531E-08 | 7.33E-03
-1.748531E-08 | 8.37E-03
-1.743531E-08 | 8.37E-03
-1.738531E-08 | 8.89E-03
-1.733531E-08 | 9.41E-03
-1.728531E-08 | 9.41E-03
-1.723531E-08 | 1.098E-02
-1.718531E-08 | 1.150E-02
-1.713531E-08 | 1.202E-02
-1.708531E-08 | 1.254E-02
-1.703531E-08 | 1.411E-02
-1.698531E-08 | 1.463E-02
-1.693531E-08 | 1.515E-02
-1.688531E-08 | 1.672E-02
-1.683531E-08 | 1.724E-02
-1.678531E-08 | 1.776E-02
-1.673531E-08 | 1.880E-02
-1.668531E-08 | 1.932E-02
-1.663531E-08 | 2.089E-02
-1.658531E-08 | 2.193E-02
-1.653531E-08 | 2.193E-02
-1.648531E-08 | 2.298E-02
-1.643531E-08 | 2.402E-02
-1.638531E-08 | 2.506E-02
-1.633531E-08 | 2.558E-02
-1.628531E-08 | 2.611E-02
-1.623531E-08 | 2.663E-02
-1.618531E-08 | 2.715E-02
-1.613531E-08 | 2.715E-02
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
