sky9464881/tof-lidar-receiver-design/results/archived/capstone_final/6.2/6.2 final opa695/6.2 final opa695_100  compartor 0 lowpass 5.6pF/att=3.0/att=3.0_00004.csv

-1.836157E-08 | 1.150E-02
-1.831157E-08 | 1.254E-02
-1.826157E-08 | 1.463E-02
-1.821157E-08 | 1.515E-02
-1.816157E-08 | 1.724E-02
-1.811157E-08 | 1.776E-02
-1.806157E-08 | 1.932E-02
-1.801157E-08 | 2.037E-02
-1.796157E-08 | 2.141E-02
-1.791157E-08 | 2.298E-02
-1.786157E-08 | 2.506E-02
-1.781157E-08 | 2.611E-02
-1.776157E-08 | 2.663E-02
-1.771157E-08 | 2.767E-02
-1.766157E-08 | 2.871E-02
-1.761157E-08 | 2.976E-02
-1.756157E-08 | 2.976E-02
-1.751157E-08 | 3.028E-02
-1.746157E-08 | 3.080E-02
-1.741157E-08 | 3.237E-02
-1.736157E-08 | 3.289E-02
-1.731157E-08 | 3.289E-02
-1.726157E-08 | 3.289E-02
-1.721157E-08 | 3.341E-02
-1.716157E-08 | 3.341E-02
-1.711157E-08 | 3.445E-02
-1.706157E-08 | 3.445E-02
-1.701157E-08 | 3.445E-02
-1.696157E-08 | 3.445E-02
-1.691157E-08 | 3.445E-02
-1.686157E-08 | 3.445E-02
-1.681157E-08 | 3.445E-02
-1.676157E-08 | 3.445E-02
-1.671157E-08 | 3.445E-02
-1.666157E-08 | 3.445E-02
-1.661157E-08 | 3.445E-02
-1.656157E-08 | 3.445E-02
-1.651157E-08 | 3.445E-02
-1.646157E-08 | 3.445E-02
-1.641157E-08 | 3.445E-02
-1.636157E-08 | 3.393E-02
-1.631157E-08 | 3.393E-02
-1.626157E-08 | 3.393E-02
-1.621157E-08 | 3.393E-02
-1.616157E-08 | 3.393E-02
-1.611157E-08 | 3.393E-02
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
