sky9464881/tof-lidar-receiver-design/results/archived/capstone_final/6.2/6.2 final opa695/6.2 final opa695_100  compartor 0 lowpass 5.6pF/att=3.0/att=3.0_00005.csv

-1.835396E-08 | 2.245E-02
-1.830396E-08 | 2.245E-02
-1.825396E-08 | 2.193E-02
-1.820396E-08 | 2.141E-02
-1.815396E-08 | 2.141E-02
-1.810396E-08 | 2.089E-02
-1.805396E-08 | 2.037E-02
-1.800396E-08 | 1.985E-02
-1.795396E-08 | 1.932E-02
-1.790396E-08 | 1.932E-02
-1.785396E-08 | 1.932E-02
-1.780396E-08 | 1.880E-02
-1.775396E-08 | 1.880E-02
-1.770396E-08 | 1.880E-02
-1.765396E-08 | 1.828E-02
-1.760396E-08 | 1.828E-02
-1.755396E-08 | 1.828E-02
-1.750396E-08 | 1.880E-02
-1.745396E-08 | 1.880E-02
-1.740396E-08 | 1.880E-02
-1.735396E-08 | 1.880E-02
-1.730396E-08 | 1.932E-02
-1.725396E-08 | 1.932E-02
-1.720396E-08 | 1.932E-02
-1.715396E-08 | 1.932E-02
-1.710396E-08 | 1.932E-02
-1.705396E-08 | 1.932E-02
-1.700396E-08 | 1.932E-02
-1.695396E-08 | 1.932E-02
-1.690396E-08 | 1.932E-02
-1.685396E-08 | 1.932E-02
-1.680396E-08 | 1.880E-02
-1.675396E-08 | 1.880E-02
-1.670396E-08 | 1.828E-02
-1.665396E-08 | 1.828E-02
-1.660396E-08 | 1.776E-02
-1.655396E-08 | 1.724E-02
-1.650396E-08 | 1.724E-02
-1.645396E-08 | 1.724E-02
-1.640396E-08 | 1.672E-02
-1.635396E-08 | 1.724E-02
-1.630396E-08 | 1.672E-02
-1.625396E-08 | 1.672E-02
-1.620396E-08 | 1.619E-02
-1.615396E-08 | 1.619E-02
-1.610396E-08 | 1.619E-02
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
