sky9464881/tof-lidar-receiver-design/results/archived/capstone_final/6.2/6.2 final opa695/6.2 final opa695_100  compartor 0 lowpass 5.6pF/att=3.0/att=3.0_00006.csv

-1.837472E-08 | 3.550E-02
-1.832472E-08 | 3.758E-02
-1.827472E-08 | 3.863E-02
-1.822472E-08 | 4.019E-02
-1.817472E-08 | 4.071E-02
-1.812472E-08 | 4.123E-02
-1.807472E-08 | 4.176E-02
-1.802472E-08 | 4.176E-02
-1.797472E-08 | 4.071E-02
-1.792472E-08 | 4.123E-02
-1.787472E-08 | 4.019E-02
-1.782472E-08 | 3.810E-02
-1.777472E-08 | 3.706E-02
-1.772472E-08 | 3.602E-02
-1.767472E-08 | 3.341E-02
-1.762472E-08 | 3.132E-02
-1.757472E-08 | 2.871E-02
-1.752472E-08 | 2.663E-02
-1.747472E-08 | 2.298E-02
-1.742472E-08 | 2.089E-02
-1.737472E-08 | 1.776E-02
-1.732472E-08 | 1.463E-02
-1.727472E-08 | 1.202E-02
-1.722472E-08 | 8.89E-03
-1.717472E-08 | 6.28E-03
-1.712472E-08 | 3.68E-03
-1.707472E-08 | 1.59E-03
-1.702472E-08 | -5.0E-04
-1.697472E-08 | -2.06E-03
-1.692472E-08 | -3.63E-03
-1.687472E-08 | -5.71E-03
-1.682472E-08 | -6.24E-03
-1.677472E-08 | -6.24E-03
-1.672472E-08 | -7.80E-03
-1.667472E-08 | -7.80E-03
-1.662472E-08 | -7.80E-03
-1.657472E-08 | -6.76E-03
-1.652472E-08 | -6.24E-03
-1.647472E-08 | -6.24E-03
-1.642472E-08 | -4.15E-03
-1.637472E-08 | -3.11E-03
-1.632472E-08 | -1.54E-03
-1.627472E-08 | 1.07E-03
-1.622472E-08 | 3.15E-03
-1.617472E-08 | 4.20E-03
-1.612472E-08 | 7.33E-03
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
