sky9464881/tof-lidar-receiver-design/simulation/block_tests/opa277/OPA277.png

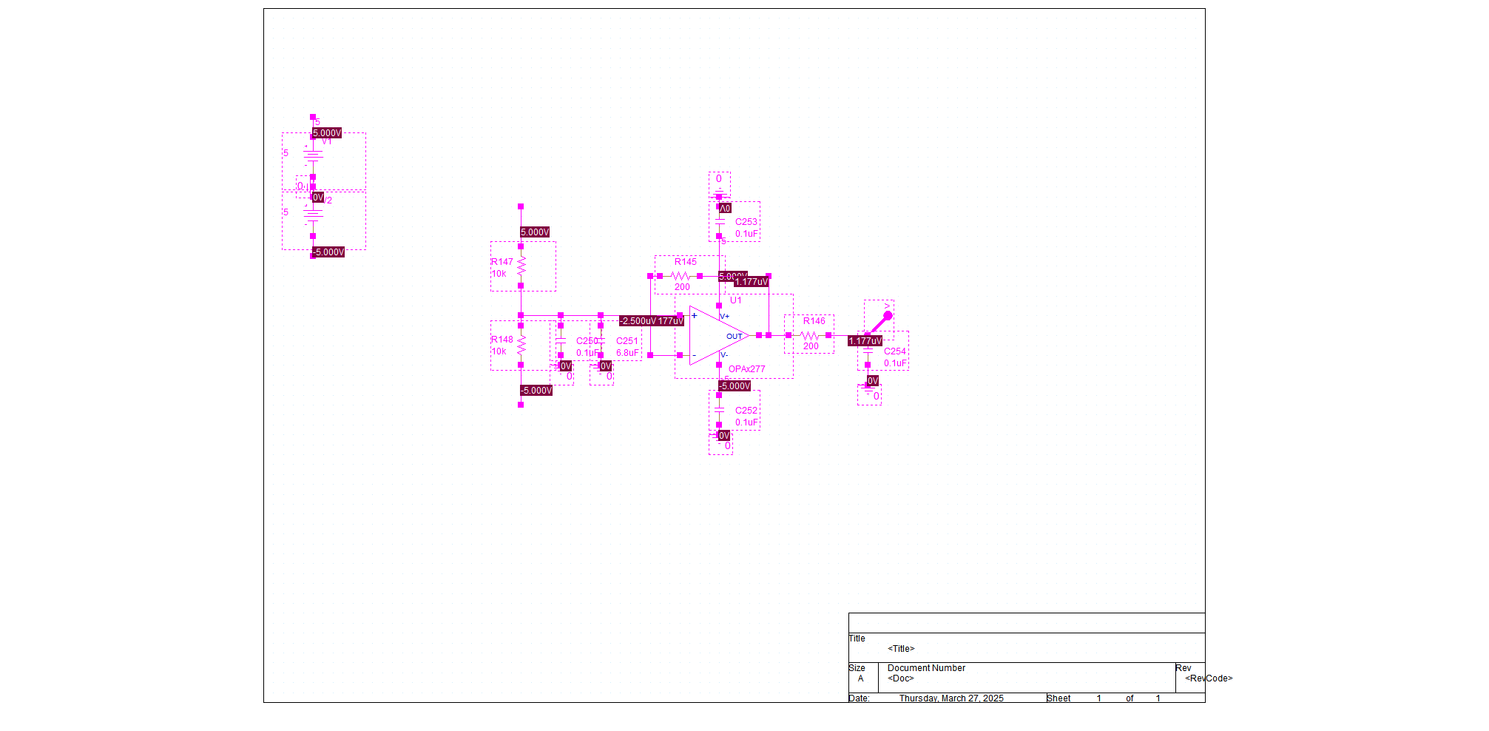
simulation/block_tests/opa277/OPA277.png
