sky9464881/tof-lidar-receiver-design/simulation/block_tests/opa695/OPA695.png

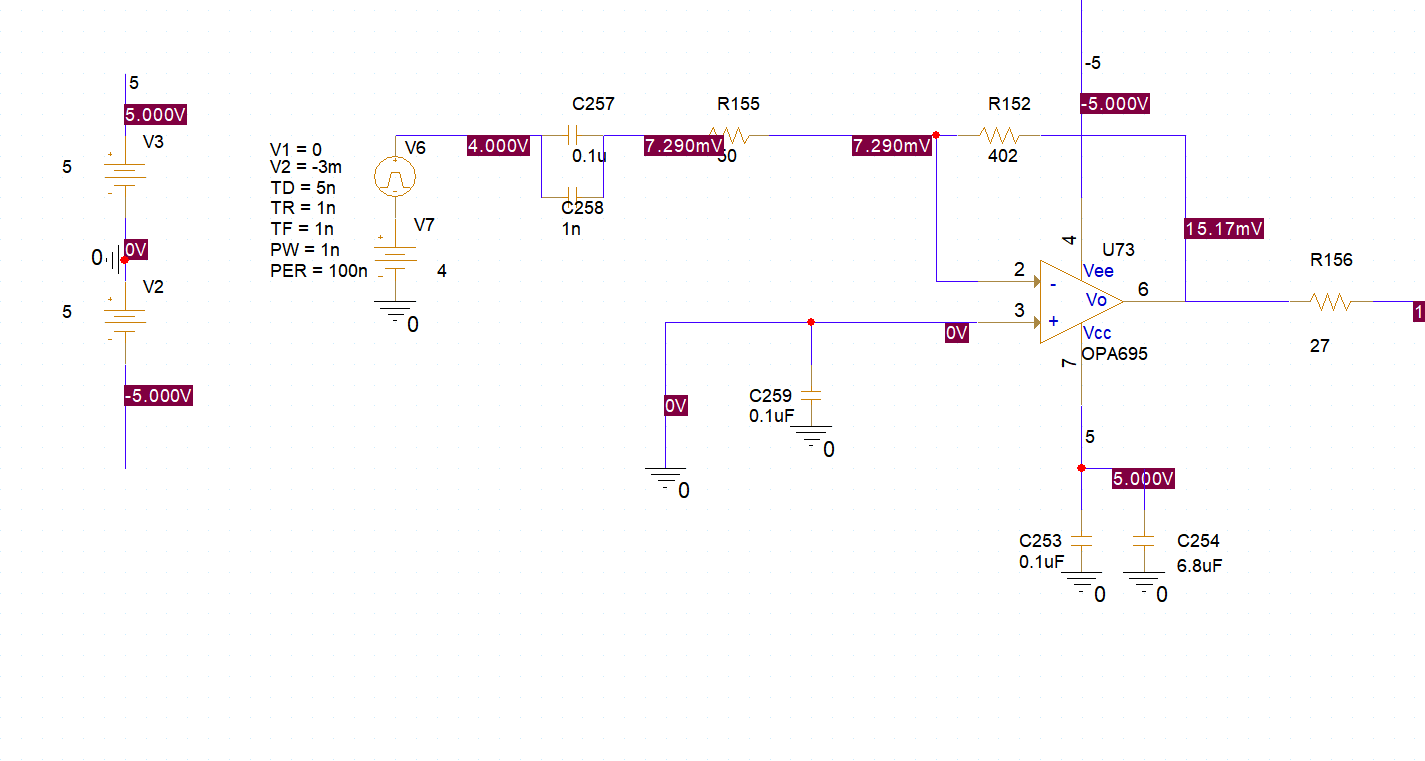
simulation/block_tests/opa695/OPA695.png
