sky9464881/tof-lidar-receiver-design/design/schematic/receiver_readout_v1.pdf

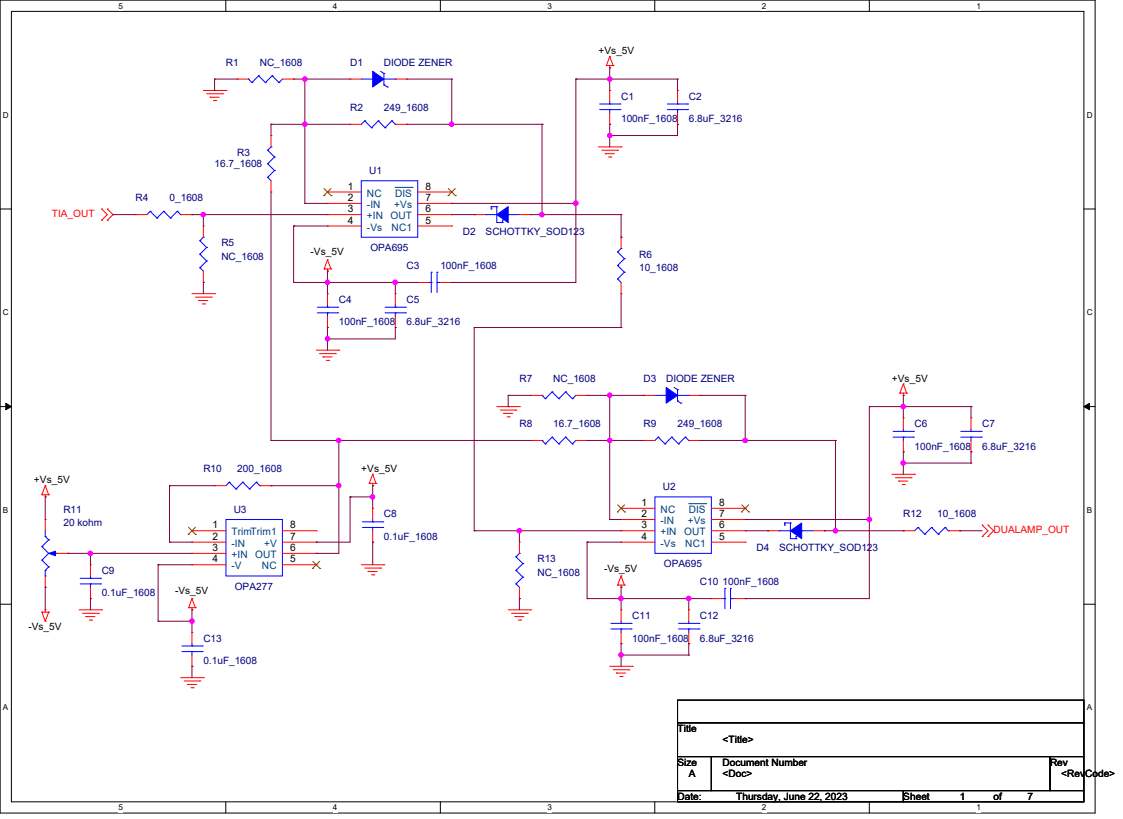
[picture p133: page 1]

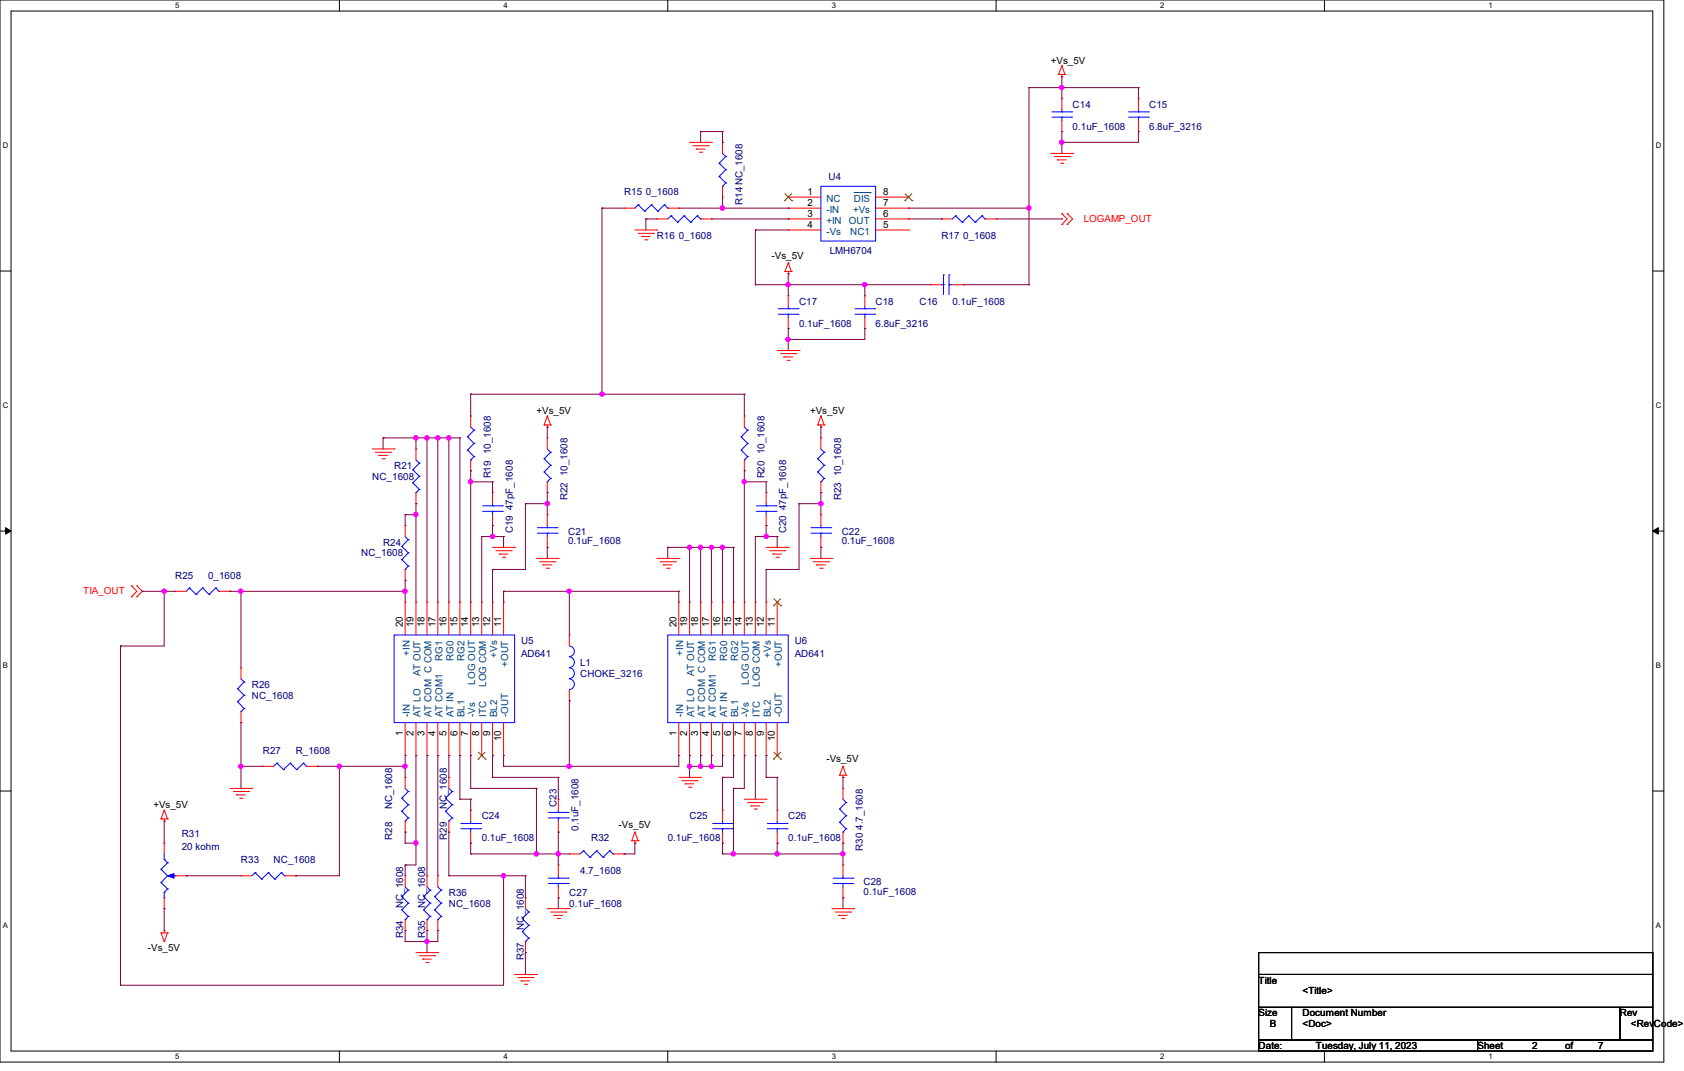
[picture p134: page 2]

9 -OUT 10 +OUT 11 +Vs 12 LOG COM 13 LOG OUT 14 RG2 15 RG0 16 RG1 17 C COM 18 AT OUT 19 +IN 20

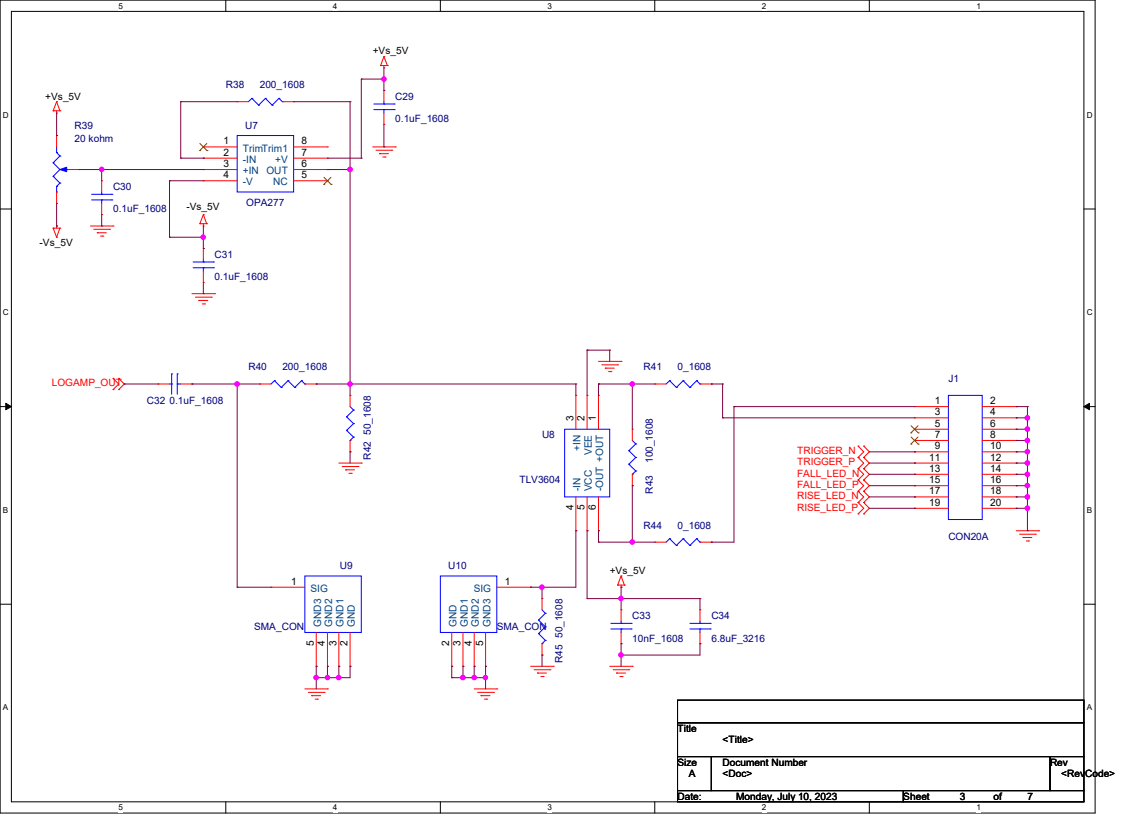
[picture p135: page 3]

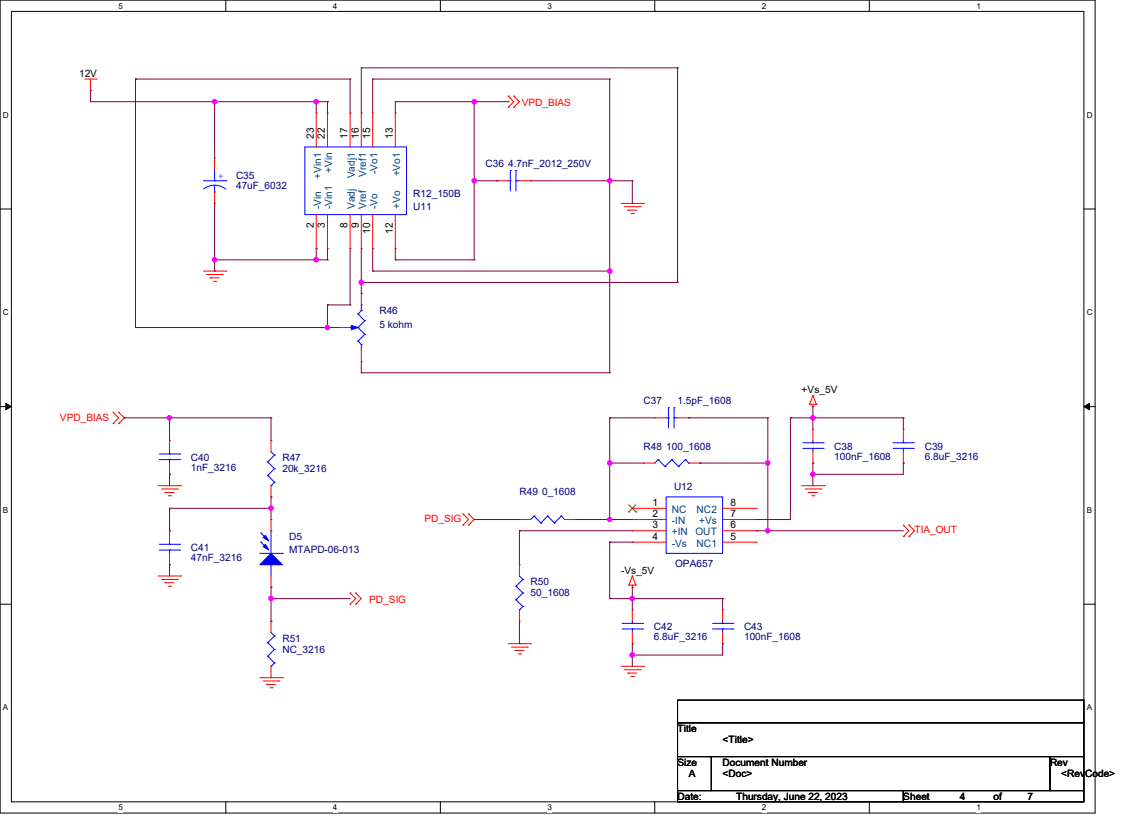
[picture p136: page 4]

3 Vadj 8 Vadj1 17 Vref 9 Vref1 16 -Vo 10 -Vo1 15 +Vo 12 +Vo1 13 +Vin 22 +Vin1 23

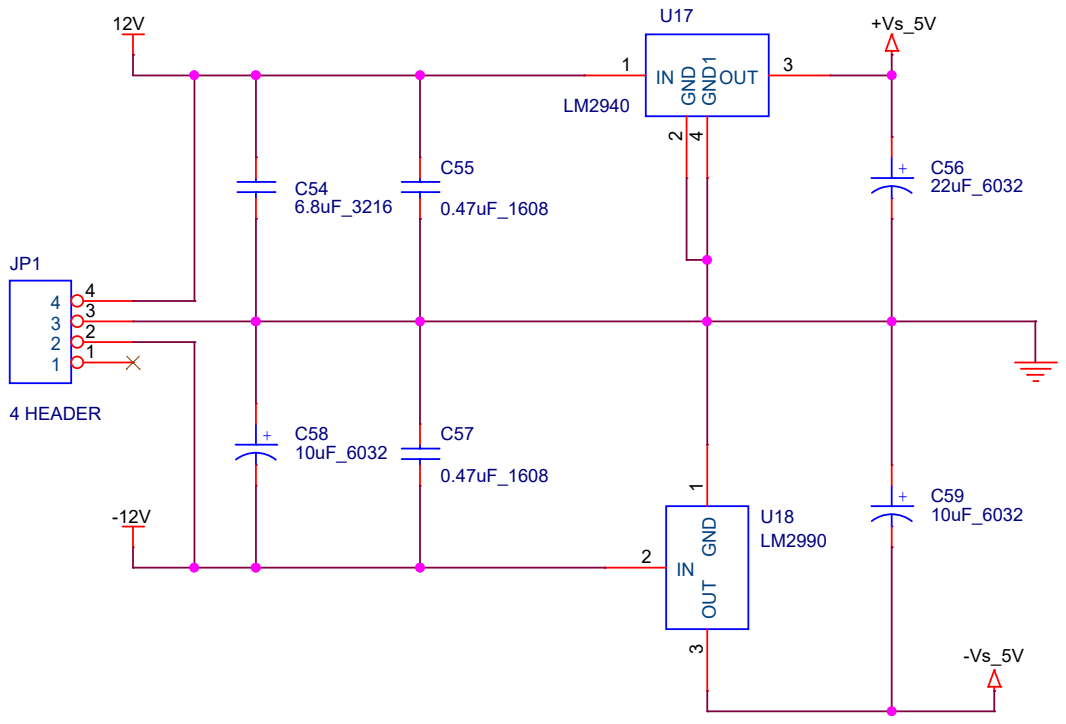
[picture p137: page 5]

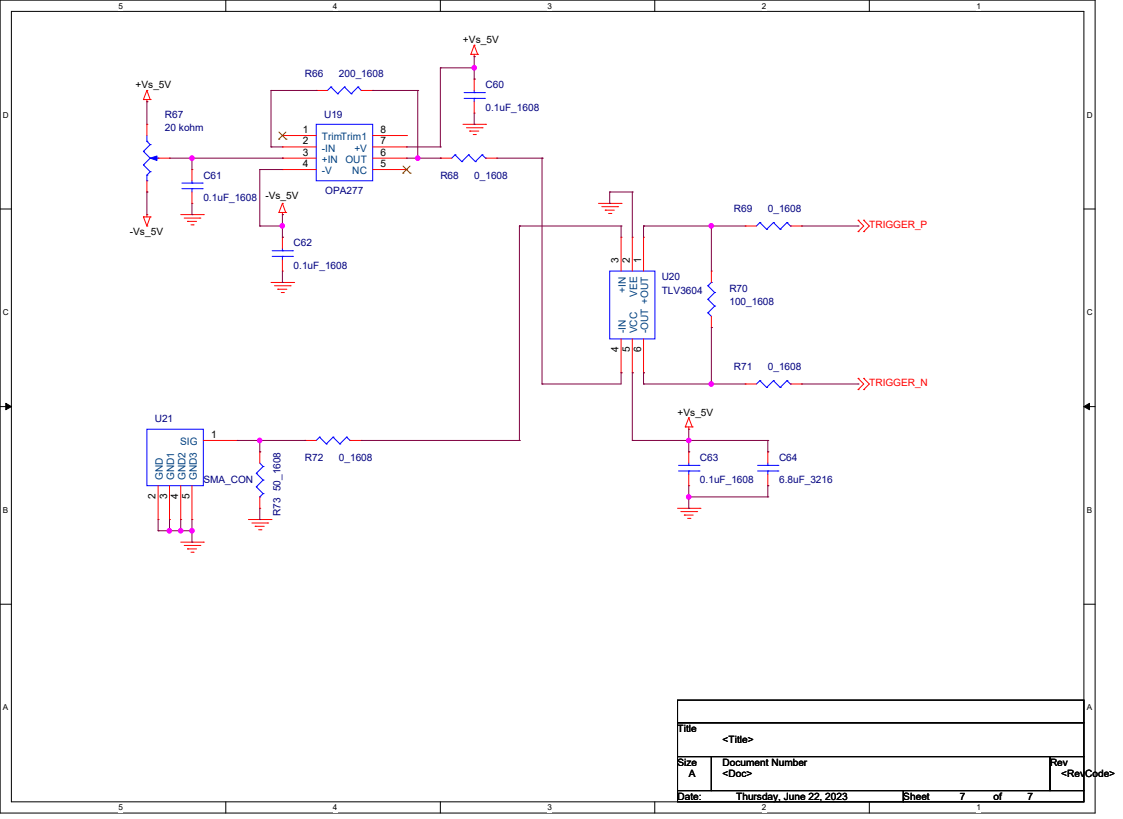
[picture p138: page 6]

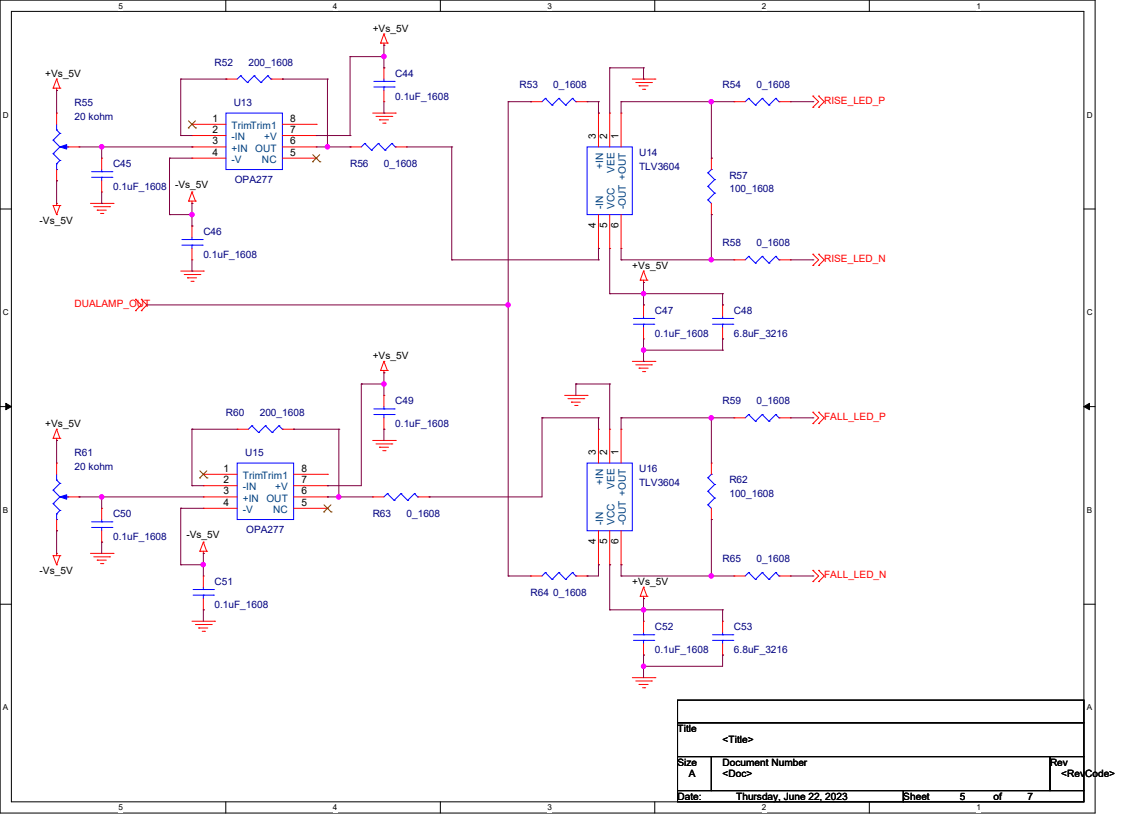
[picture p139: page 7]
