sky9464881/tof-lidar-receiver-design/(list of files, drawings)

Other design files:
design/footprint_library/LIBRARY1.OLB
design/footprint_library/LIDAR_READOUT_LIBRARY.OLB
design/footprint_library/mtapd.OLB
design/footprint_library/mtapd/mtapd.OLB
design/footprint_library/opa855.olb
simulation/archived_workspace_projects/aefdsczxf/AEFDSCZXF.DSN
simulation/archived_workspace_projects/aefdsczxf/aefdsczxf.opj
simulation/archived_workspace_projects/apdtest/APDTEST.DSN
simulation/archived_workspace_projects/apdtest/apdtest.opj
simulation/archived_workspace_projects/aserfaser/ASERFASER.DSN
simulation/archived_workspace_projects/aserfaser/aserfaser.opj
simulation/archived_workspace_projects/asfq23wcasdcd/ASFQ23WCASDCD.DSN
simulation/archived_workspace_projects/asfq23wcasdcd/asfq23wcasdcd.opj
simulation/archived_workspace_projects/awetrawe/AWETRAWE.DSN
simulation/archived_workspace_projects/awetrawe/awetrawe.opj
simulation/archived_workspace_projects/comparator/COMPARATOR.DSN
simulation/archived_workspace_projects/comparator/Comparator.opj
simulation/archived_workspace_projects/dasdq/DASDQ.DSN
simulation/archived_workspace_projects/dasdq/dasdq.opj
simulation/archived_workspace_projects/del1/DEL1.DSN
simulation/archived_workspace_projects/del1/del1.opj
simulation/archived_workspace_projects/del2/DEL2.DSN
simulation/archived_workspace_projects/del2/del2.opj
simulation/archived_workspace_projects/del13/DEL13.DSN
simulation/archived_workspace_projects/del13/del13.opj
simulation/archived_workspace_projects/del123/DEL123.DSN
simulation/archived_workspace_projects/del123/del123.opj
simulation/archived_workspace_projects/del13213/del13213/DEL13213.DSN
simulation/archived_workspace_projects/del13213/del13213/del13213.opj
simulation/archived_workspace_projects/fweqfrawe/FWEQFRAWE.DSN
simulation/archived_workspace_projects/fweqfrawe/fweqfrawe.opj
simulation/archived_workspace_projects/pto/PTO.DSN
simulation/archived_workspace_projects/pto/pto.opj
simulation/archived_workspace_projects/sfafa/SFAFA.DSN
simulation/archived_workspace_projects/sfafa/sfafa.opj
simulation/archived_workspace_projects/tesr123123/TESR123123.DSN
simulation/archived_workspace_projects/tesr123123/tesr123123.opj
simulation/archived_workspace_projects/test1231123123/TEST1231123123.DSN
simulation/archived_workspace_projects/test1231123123/test1231123123.opj
simulation/archived_workspace_projects/test_opa695/TEST_OPA695.DSN
simulation/archived_workspace_projects/test_opa695/test_opa695.opj
simulation/archived_workspace_projects/testpcb/TESTPCB.DSN
simulation/archived_workspace_projects/testpcb/testpcb.opj
simulation/archived_workspace_projects/tia(opa855)/TIA(OPA855).DSN
simulation/archived_workspace_projects/tia(opa855)/TIA(OPA855).opj
simulation/archived_workspace_projects/tia/TIA.DSN
simulation/archived_workspace_projects/tia/tia.opj
simulation/archived_workspace_projects/tiaopa695/TIAOPA695.DSN
simulation/archived_workspace_projects/tiaopa695/TIAOPA695.opj
simulation/archived_workspace_projects/twrawr/TWRAWR.DSN
simulation/archived_workspace_projects/twrawr/twrawr.opj
simulation/archived_workspace_projects/twtstwtw/TWTSTWTW.DSN
simulation/archived_workspace_projects/twtstwtw/twtstwtw.opj
simulation/archived_workspace_projects/vavqvqq/VAVQVQQ.DSN
simulation/archived_workspace_projects/vavqvqq/vavqvqq.opj
simulation/archived_workspace_projects/wrearawsdf/WREARAWSDF.DSN
simulation/archived_workspace_projects/wrearawsdf/wrearawsdf.opj
simulation/archived_workspace_projects/xvaszdvaswd/XVASZDVASWD.DSN
simulation/archived_workspace_projects/xvaszdvaswd/xvaszdvaswd.opj
simulation/archived_workspace_projects/yrewtwer/YREWTWER.DSN
simulation/archived_workspace_projects/yrewtwer/yrewtwer.opj
simulation/archived_workspace_projects/zxcwcq/ZXCWCQ.DSN
simulation/archived_workspace_projects/zxcwcq/zxcwcq.opj
simulation/block_tests/opa277/OPA277.DSN
simulation/block_tests/opa277/opa277.opj
simulation/block_tests/opa695/OPA695.DSN
simulation/block_tests/opa695/opa695.opj
simulation/etc/legacy_pcb_bundle/LIDAR_PCB.DSN
simulation/etc/legacy_pcb_bundle/LIDAR_PCB.opj
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
