sky9464881/tof-lidar-receiver-design/(commit log)

2026-03-28 파일 정리 및 자료 정리
    [4header.psm, 80DB_LIDAR.DSN, 80DB_LIDAR.brd, 80DB_LIDAR_1.brd, 80dB_LiDAR.opj, AEFDSCZXF.DSN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]
2026-03-28 발표자료 수정
2026-03-28 발표자료수정
